holmch11/CVHS_ROV/README.md

# CVHS_ROV
Low Cost 4 Thruster ROV
<<<<<<< Updated upstream
See PDFs or CVHS_ROV_USER_MANUAL for further information
=======
See Pdfs for code map and CVHS_ROV_USER_MANUAL for usage info
>>>>>>> Stashed changes
