holmch11/CVHS_ROV/DXFs/2302-01202-00002.dxf

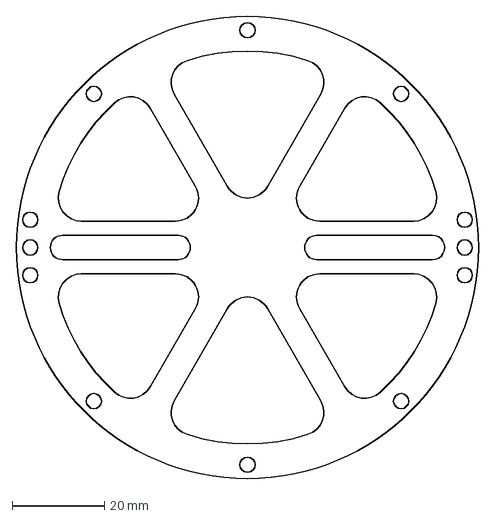
[picture p1: CAD file, 2024-09-09]
DXFs/2302-01202-00002.dxf
100.0 x 100.0 mm
