holmch11/CVHS_ROV/STLs/2302-01200-00009.stl

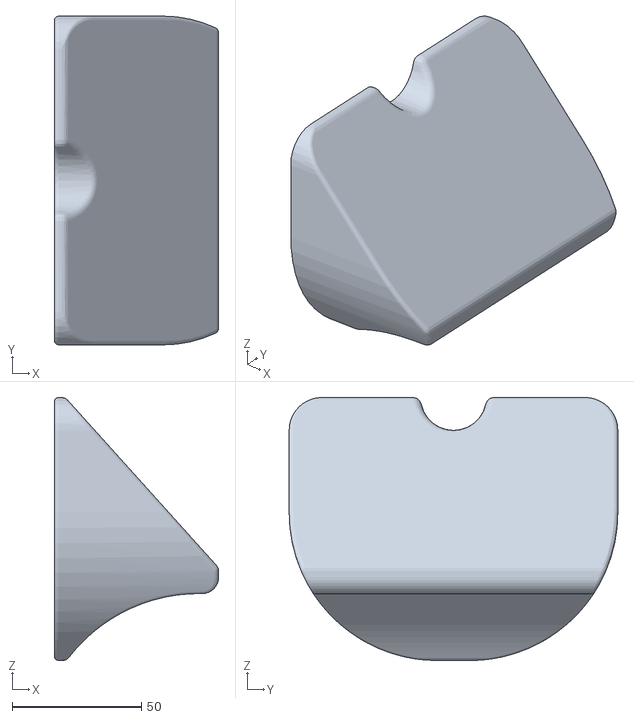
[picture p2: CAD file, 2024-09-09]
STLs/2302-01200-00009.stl
63.5 x 127.0 x 101.6
