holmch11/CVHS_ROV/DXFs/2302-01202-00003.dxf

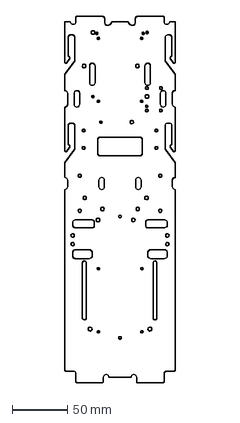
[picture p3: CAD file, 2024-09-09]
DXFs/2302-01202-00003.dxf
100.0 x 331.8 mm
