holmch11/CVHS_ROV/STLs/2302-01200-00003.stl

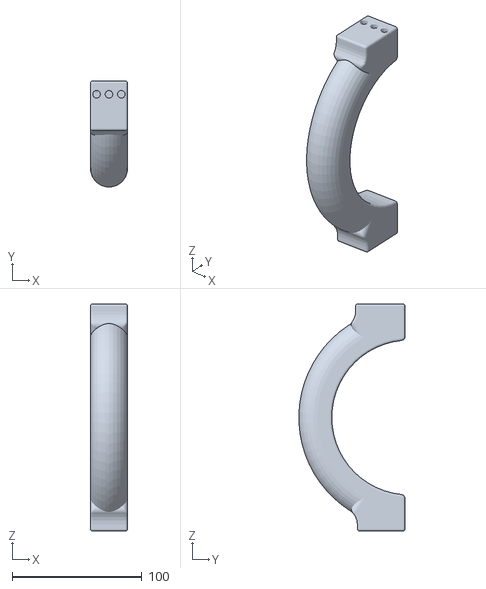
[picture p4: CAD file, 2024-09-09]
STLs/2302-01200-00003.stl
28.6 x 81.7 x 174.6
