holmch11/CVHS_ROV/DXFs/2302-01202-00009.dxf

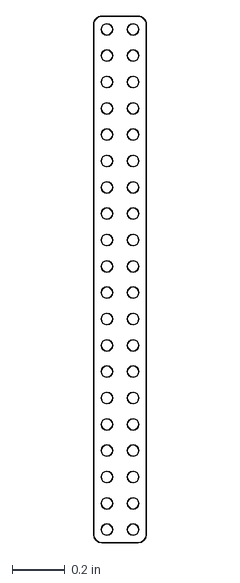
[picture p5: CAD file, 2024-09-09]
DXFs/2302-01202-00009.dxf
0.2 x 2.00 in
