holmch11/CVHS_ROV/STLs/2302-01200-00010.stl

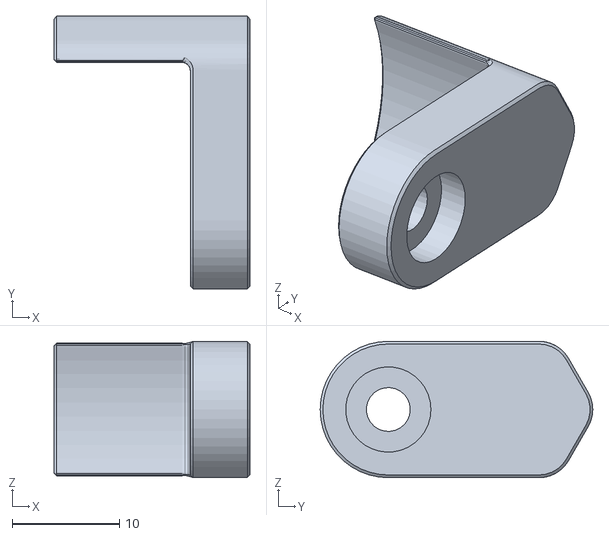
[picture p6: CAD file, 2024-09-09]
STLs/2302-01200-00010.stl
18.3 x 25.4 x 12.7
