holmch11/CVHS_ROV/DXFs/2302-01200-00002.dxf

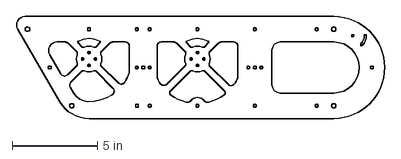
[picture p7: CAD file, 2024-09-09]
DXFs/2302-01200-00002.dxf
21.7 x 6.00 in
