holmch11/CVHS_ROV/STLs/2302-01200-10008.stl

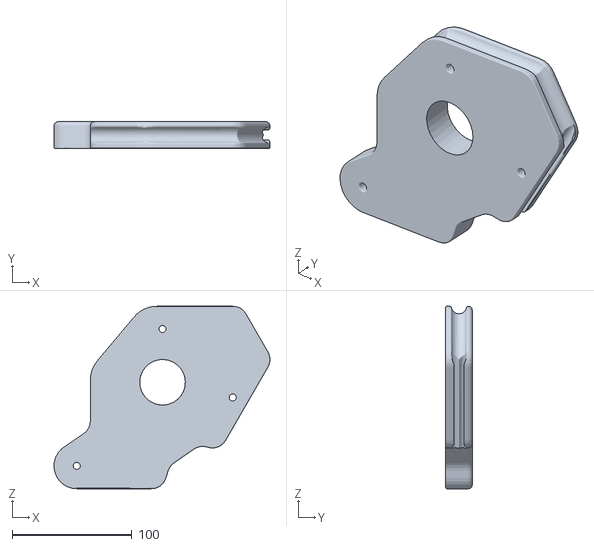
[picture p8: CAD file, 2024-09-09]
STLs/2302-01200-10008.stl
180.4 x 22.2 x 152.4
