holmch11/CVHS_ROV/STLs/2302-01202-00010.stl

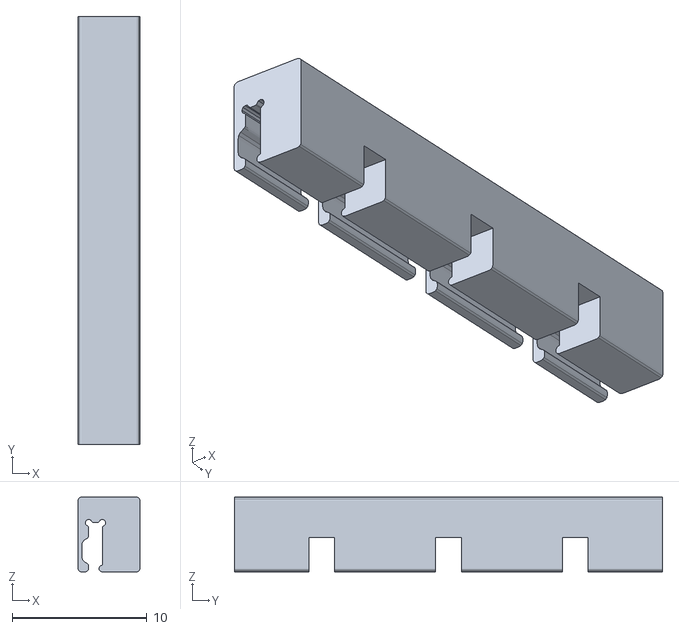
[picture p9: CAD file, 2024-09-09]
STLs/2302-01202-00010.stl
4.60 x 31.8 x 5.56
