holmch11/CVHS_ROV/PDFs/2302-01202_CVHS_ELECTRONICS_BOTTLE_ASSEMBLY_REV-A_2024-09-06.pdf

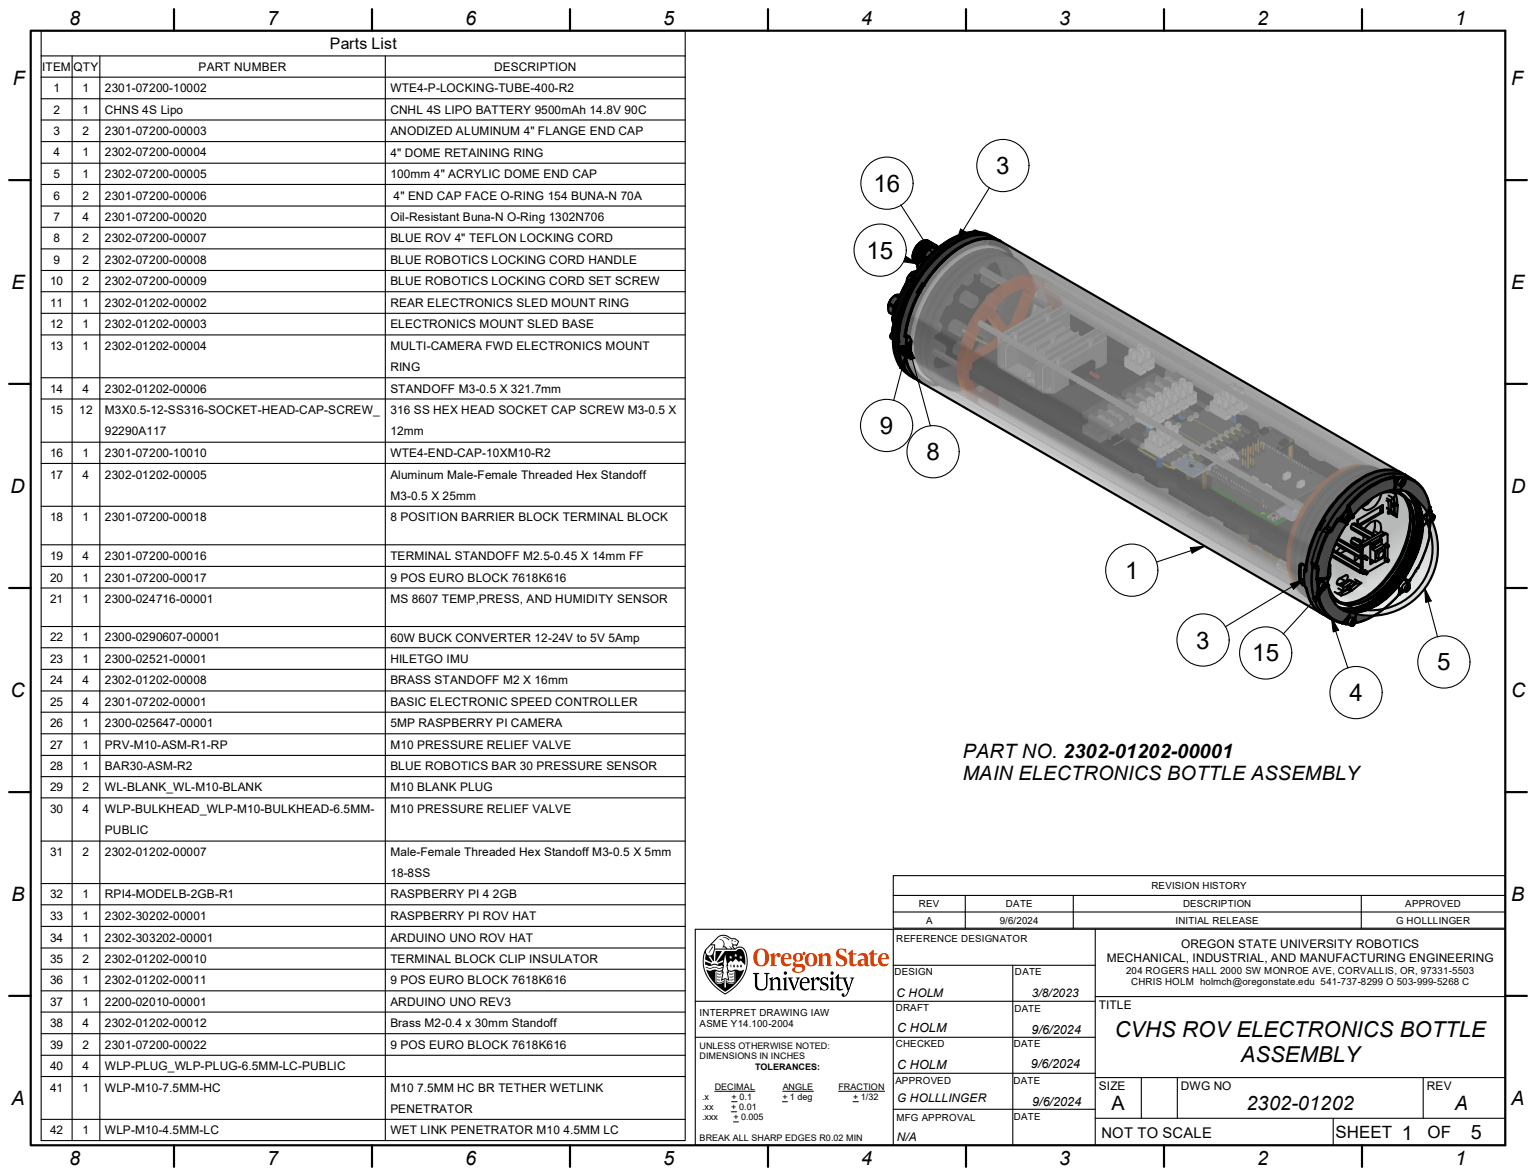
[picture p18: page 1]
Parts List; ARDUINO UNO ROV HAT; TERMINAL BLOCK CLIP INSULATOR; 9 POS EURO BLOCK 7618K616; WLP-M10-4.5MM-LC; WET LINK PENETRATOR M10 4.5MM LC; + 1 deg; .xxx; DWG NO; SHEET 1; MFG APPROVAL; REFERENCE DESIGNATOR; G HOLLLINGER; C HOLM; REVISION HISTORY

ITEM QTY | | PART NUMBER | DESCRIPTION

1 | 1 | 2301-07200-10002 | WTE4-P-LOCKING-TUBE-400-R2

2 | 1 | CHNS 4S Lipo | CNHL 4S LIPO BATTERY 9500mAh 14.8V 90C

3 | 2 | 2301-07200-00003 | ANODIZED ALUMINUM 4" FLANGE END CAP

4 | 1 | 2302-07200-00004 | 4" DOME RETAINING RING

5 | 1 | 2302-07200-00005 | 100mm 4" ACRYLIC DOME END CAP

6 | 2 | 2301-07200-00006 | 4" END CAP FACE O-RING 154 BUNA-N 70A

7 | 4 | 2301-07200-00020 | Oil-Resistant Buna-N O-Ring 1302N706

8 | 2 | 2302-07200-00007 | BLUE ROV 4" TEFLON LOCKING CORD

9 | 2 | 2302-07200-00008 | BLUE ROBOTICS LOCKING CORD HANDLE

10 | 2 | 2302-07200-00009 | BLUE ROBOTICS LOCKING CORD SET SCREW

11 | 1 | 2302-01202-00002 | REAR ELECTRONICS SLED MOUNT RING

12 | 1 | 2302-01202-00003 | ELECTRONICS MOUNT SLED BASE

13 | 1 | 2302-01202-00004 | MULTI-CAMERA FWD ELECTRONICS MOUNT RING

14 | 4 | 2302-01202-00006 | STANDOFF M3-0.5 X 321.7mm

15 | 12 | M3X0.5-12-SS316-SOCKET-HEAD-CAP-SCREW_ 92290A117 | 316 SS HEX HEAD SOCKET CAP SCREW M3-0.5 X 12mm

16 | 1 | 2301-07200-10010 | WTE4-END-CAP-10XM10-R2

17 | 4 | 2302-01202-00005 | Aluminum Male-Female Threaded Hex Standoff M3-0.5 X 25mm

18 | 1 | 2301-07200-00018 | 8 POSITION BARRIER BLOCK TERMINAL BLOCK

19 | 4 | 2301-07200-00016 | TERMINAL STANDOFF M2.5-0.45 X 14mm FF

20 | 1 | 2301-07200-00017 | 9 POS EURO BLOCK 7618K616

21 | 1 | 2300-024716-00001 | MS 8607 TEMP,PRESS, AND HUMIDITY SENSOR

22 | 1 | 2300-0290607-00001 | 60W BUCK CONVERTER 12-24V to 5V 5Amp

23 | 1 | 2300-02521-00001 | HILETGO IMU

24 | 4 | 2302-01202-00008 | BRASS STANDOFF M2 X 16mm

25 | 4 | 2301-07202-00001 | BASIC ELECTRONIC SPEED CONTROLLER

26 | 1 | 2300-025647-00001 | 5MP RASPBERRY PI CAMERA

27 | 1 | PRV-M10-ASM-R1-RP | M10 PRESSURE RELIEF VALVE

PART NO. 2302-01202-00001
MAIN ELECTRONICS BOTTLE ASSEMBLY

28 | 1 | BAR30-ASM-R2 | BLUE ROBOTICS BAR 30 PRESSURE SENSOR

29 | 2 | WL-BLANK_WL-M10-BLANK | M10 BLANK PLUG

30 | 4 | WLP-BULKHEAD_WLP-M10-BULKHEAD-6.5MM-PUBLIC | M10 PRESSURE RELIEF VALVE

31 | 2 | 2302-01202-00007 | Male-Female Threaded Hex Standoff M3-0.5 X 5mm 18-8SS

32 | 1 | RPI4-MODELB-2GB-R1 | RASPBERRY PI 4 2GB

33 | 1 | 2302-30202-00001 | RASPBERRY PI ROV HAT

REV | DATE | DESCRIPTION | APPROVED
A | 9/6/2024 | INITIAL RELEASE | G HOLLLINGER

OREGON STATE UNIVERSITY ROBOTICS

MECHANICAL, INDUSTRIAL, AND MANUFACTURING ENGINEERING
204 ROGERS HALL 2000 SW MONROE AVE, CORVALLIS, OR, 97331-5503
CHRIS HOLM holmch@oregonstate.edu 541-737-8299 O 503-999-5268 C

37 | 1 | 2200-02010-00001 | ARDUINO UNO REV3

INTERPRET DRAWING IAW ASME Y14.100-2004 | DRAFT C HOLM | DATE 9/6/2024

TITLE
CVHS ROV ELECTRONICS BOTTLE

38 | 4 | 2302-01202-00012 | Brass M2-0.4 x 30mm Standoff

UNLESS OTHERWISE NOTED:
DIMENSIONS IN INCHES

M10 7.5MM HC BR TETHER WETLINK

BREAK ALL SHARP EDGES R0.02 MIN

NOT TO SCALE

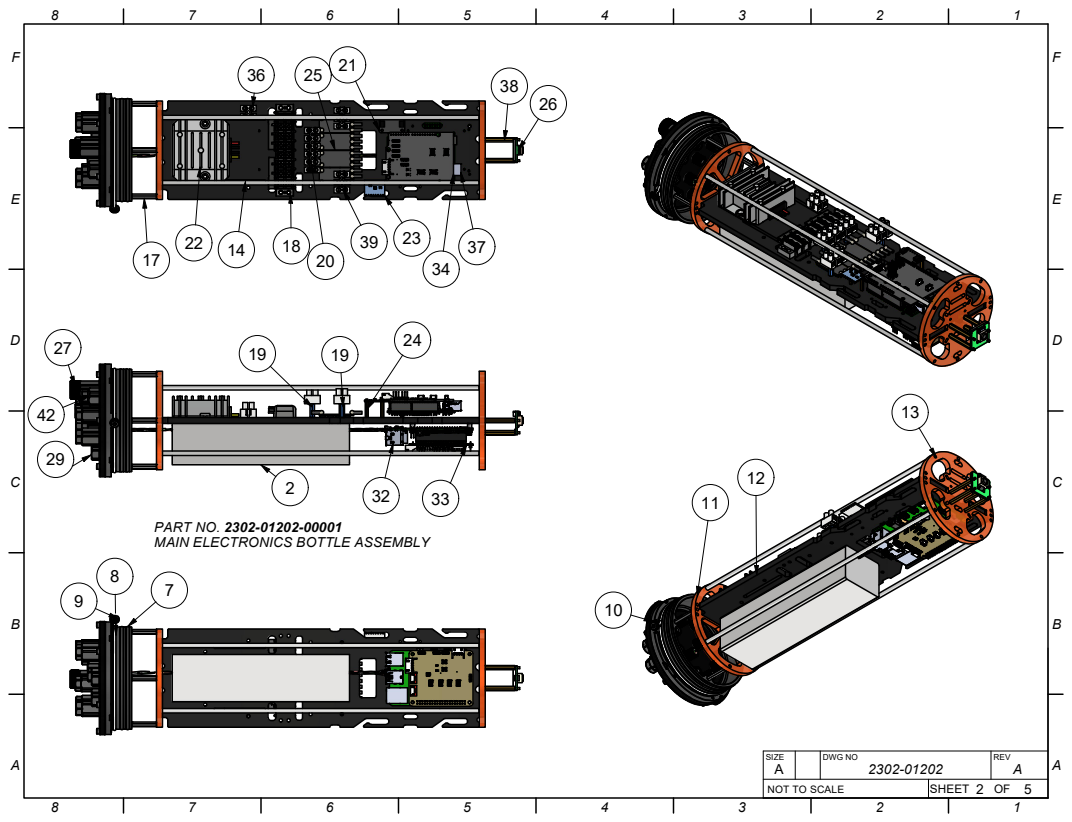
[picture p19: page 2]
SIZE; DWG NO; REV; NOT TO SCALE; SHEET

PART NO. 2302-01202-00001
MAIN ELECTRONICS BOTTLE ASSEMBLY

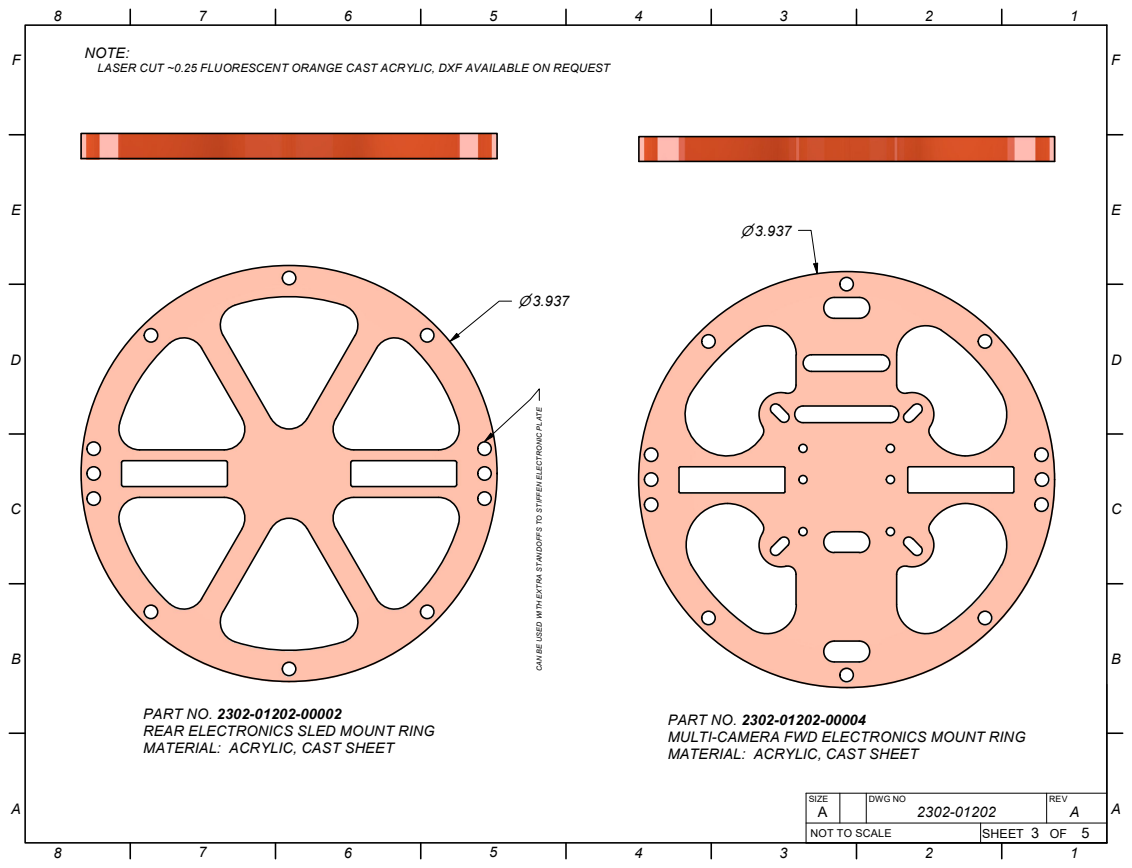
[picture p20: page 3]
SIZE; DWG NO; REV

NOTE:
LASER CUT ~0.25 FLUORESCENT ORANGE CAST ACRYLIC, DXF AVAILABLE ON REQUEST

CAN BE USED WITH EXTRA STANDOFFS TO STIFFEN ELECTRONIC PLATE

PART NO. 2302-01202-00002
REAR ELECTRONICS SLED MOUNT RING
MATERIAL: ACRYLIC, CAST SHEET

PART NO. 2302-01202-00004
MULTI-CAMERA FWD ELECTRONICS MOUNT RING

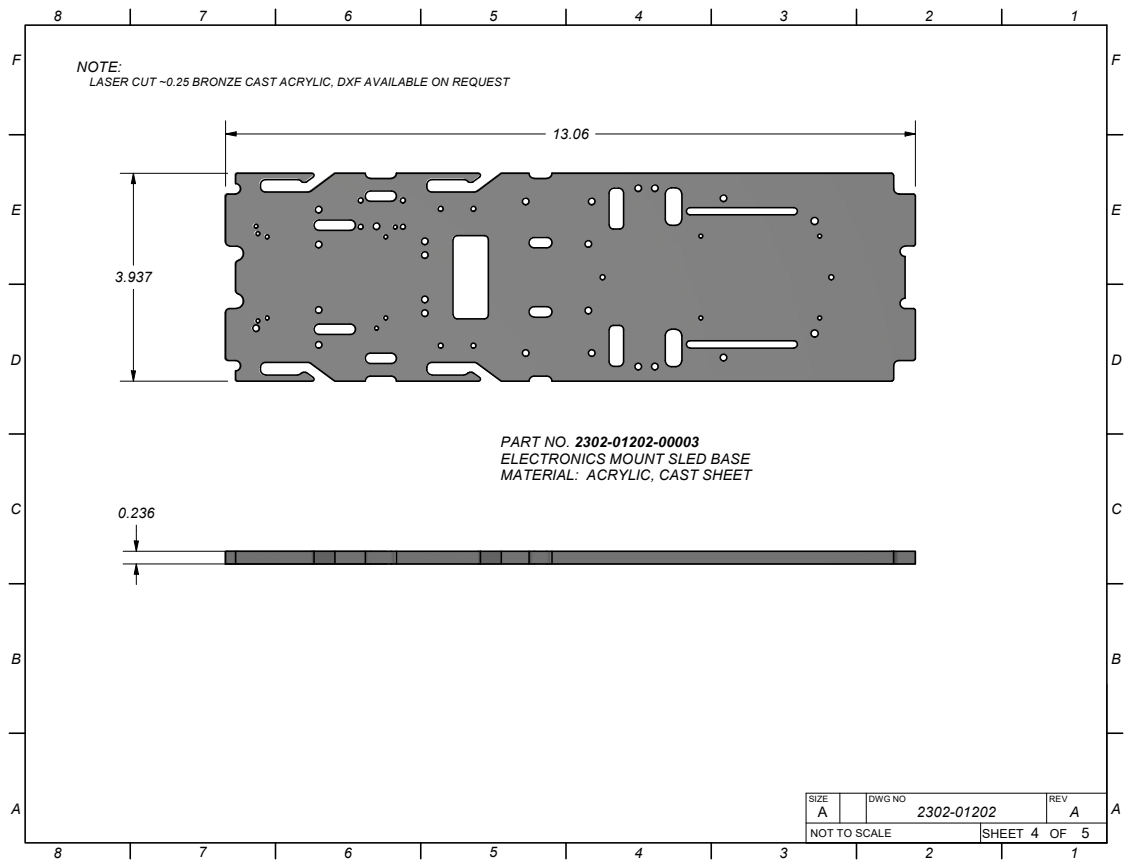
[picture p21: page 4]
SIZE; DWG NO; REV

NOTE:
LASER CUT ~0.25 BRONZE CAST ACRYLIC, DXF AVAILABLE ON REQUEST

PART NO. 2302-01202-00003
ELECTRONICS MOUNT SLED BASE
MATERIAL: ACRYLIC, CAST SHEET

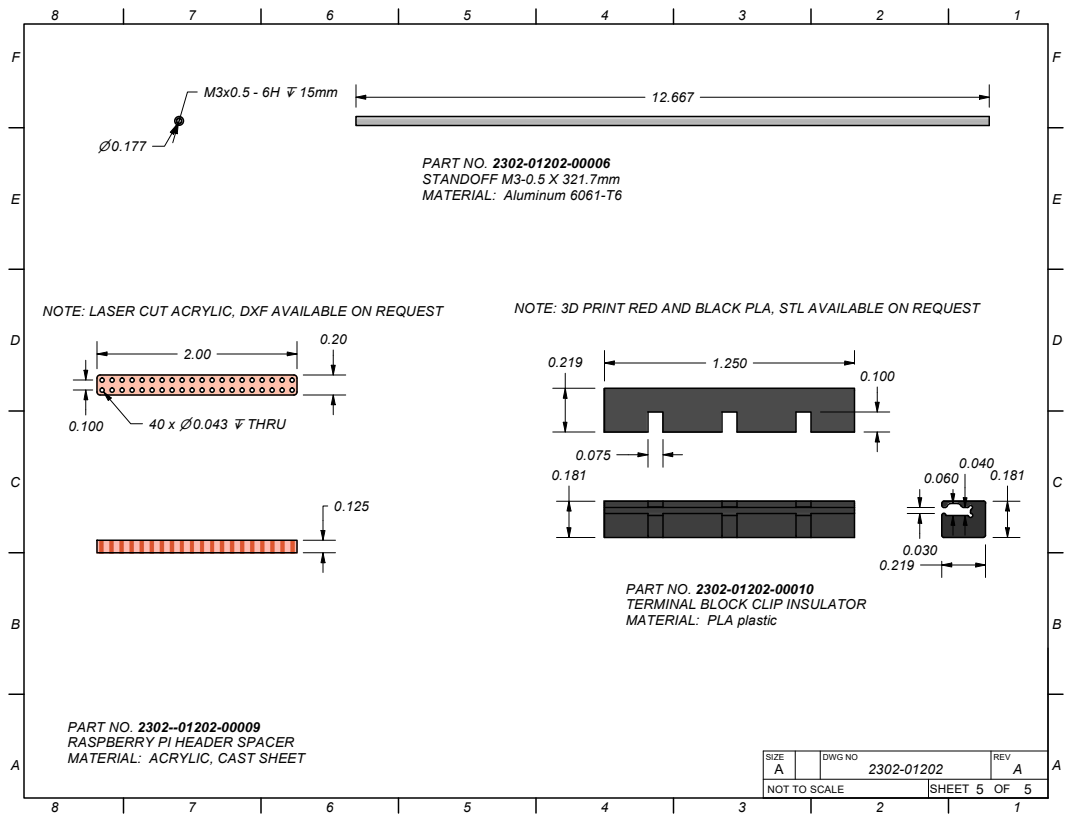
[picture p22: page 5]
PART NO. 2302-01202-00006 STANDOFF M3-0.5 X 321.7mm MATERIAL: Aluminum 6061-T6; SIZE; DWG NO; REV; 40 x ⌀ 0.043 ↧ THRU; NOTE: LASER CUT ACRYLIC, DXF AVAILABLE ON REQUEST; NOTE: 3D PRINT RED AND BLACK PLA, STL AVAILABLE ON REQUEST

PART NO. 2302-01202-00010
TERMINAL BLOCK CLIP INSULATOR
MATERIAL: PLA plastic

PART NO. 2302--01202-00009
RASPBERRY PI HEADER SPACER
MATERIAL: ACRYLIC, CAST SHEET
