holmch11/CVHS_ROV/PDFs/2302-01200_CVHS_4_THRUSTER_ROV_ASSEMBLY_REV-A_2024-09-06.pdf

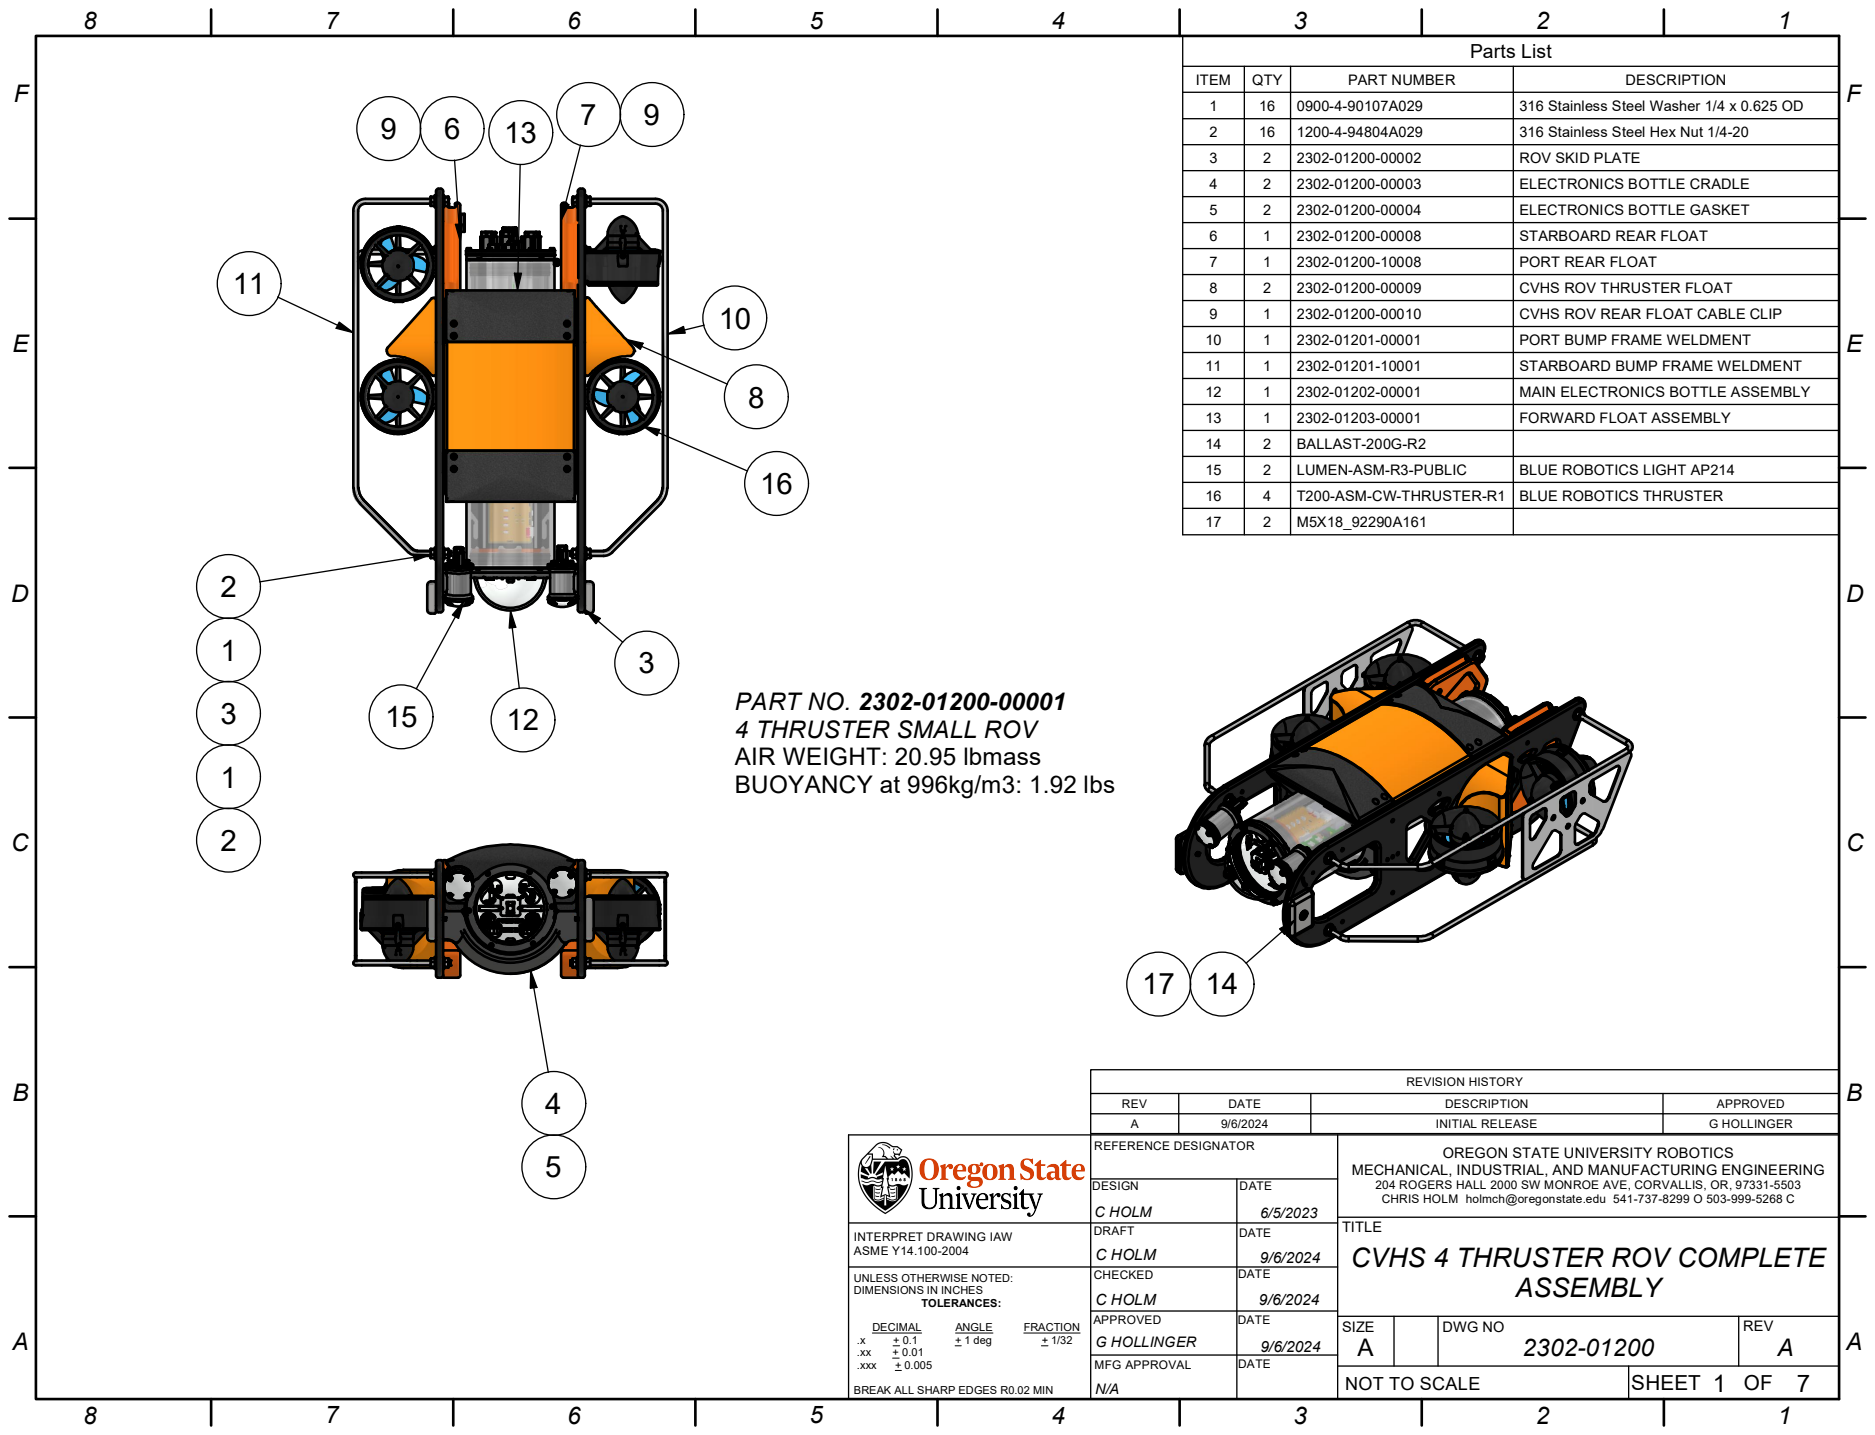
[picture p23: page 1]
Parts List; ITEM; QTY; PART NUMBER; DESCRIPTION; 316 Stainless Steel Washer 1/4 x 0.625 OD; 316 Stainless Steel Hex Nut 1/4-20; ROV SKID PLATE; ELECTRONICS BOTTLE CRADLE; ELECTRONICS BOTTLE GASKET; STARBOARD REAR FLOAT; PORT REAR FLOAT; CVHS ROV THRUSTER FLOAT; CVHS ROV REAR FLOAT CABLE CLIP; PORT BUMP FRAME WELDMENT; STARBOARD BUMP FRAME WELDMENT; MAIN ELECTRONICS BOTTLE ASSEMBLY; FORWARD FLOAT ASSEMBLY; LUMEN-ASM-R3-PUBLIC; BLUE ROBOTICS LIGHT AP214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

PART NO. 2302-01200-00001
4 THRUSTER SMALL ROV
AIR WEIGHT: 20.95 lbmass
BUOYANCY at 996kg/m3: 1.92 lbs

OREGON STATE UNIVERSITY ROBOTICS

MECHANICAL, INDUSTRIAL, AND MANUFACTURING ENGINEERING
204 ROGERS HALL 2000 SW MONROE AVE, CORVALLIS, OR, 97331-5503
CHRIS HOLM holmch@oregonstate.edu 541-737-8299 O 503-999-5268 C

TITLE
CVHS 4 THRUSTER ROV COMPLETE

INTERPRET DRAWING IAW
ASME Y14.100-2004

UNLESS OTHERWISE NOTED:
DIMENSIONS IN INCHES

BREAK ALL SHARP EDGES R0.02 MIN

NOT TO SCALE

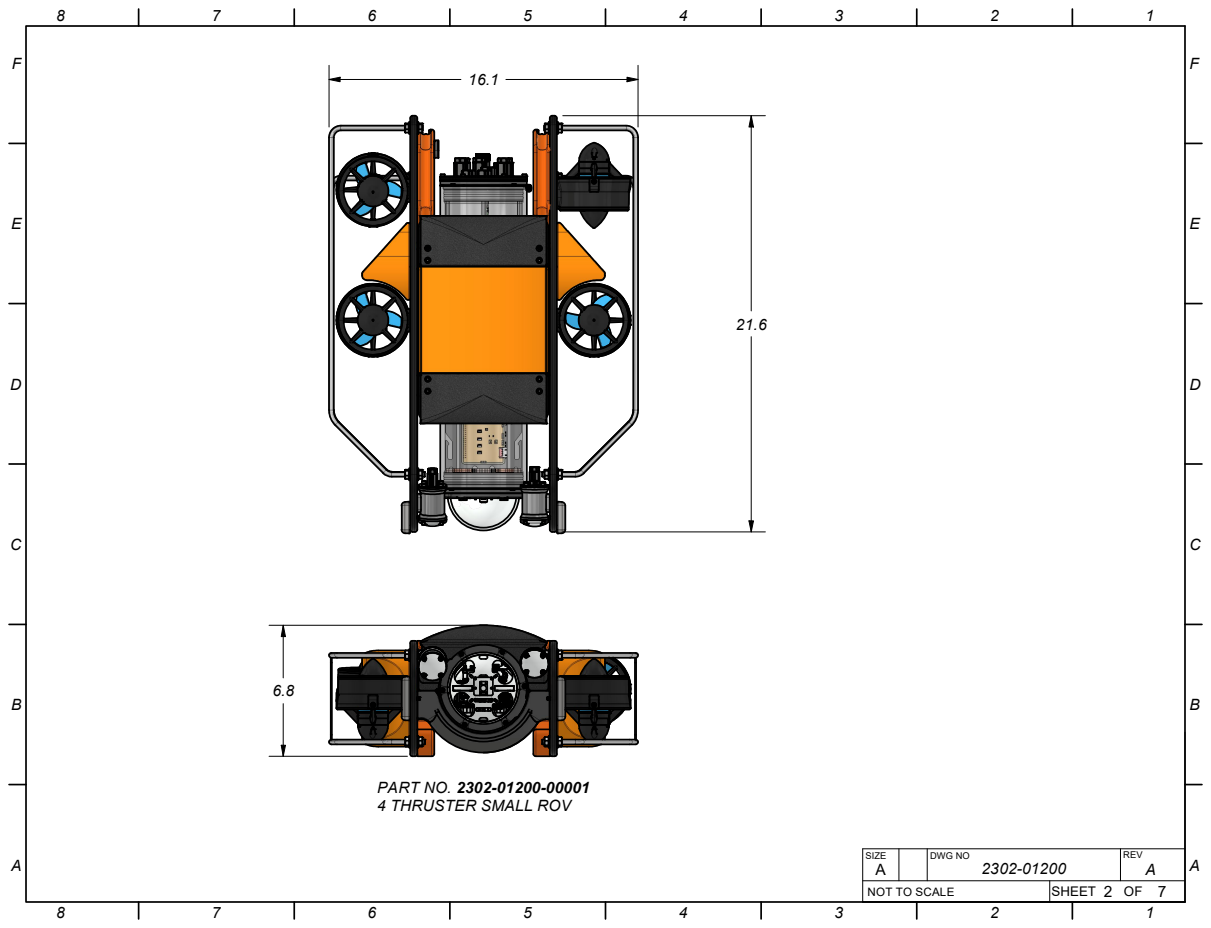
[picture p24: page 2]

PART NO. 2302-01200-00001
4 THRUSTER SMALL ROV

SIZE | | DWG NO | REV

NOT TO SCALE | SHEET OF

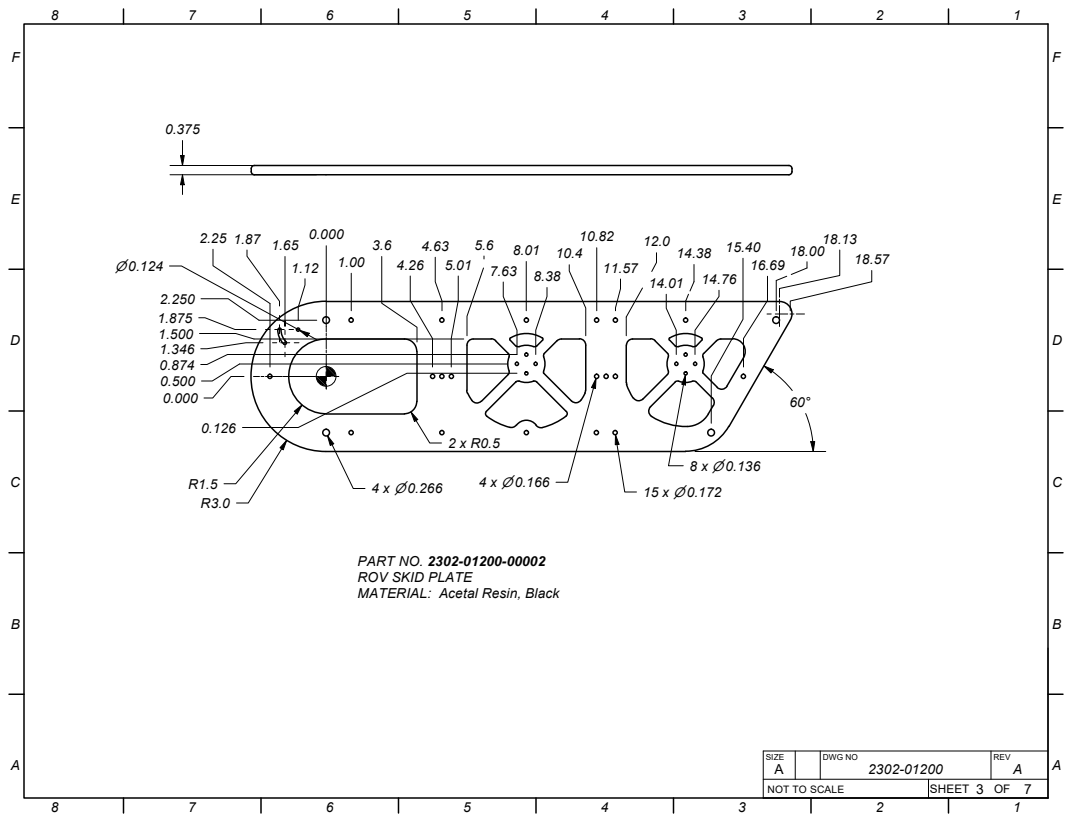
[picture p25: page 3]
SIZE; DWG NO; REV

PART NO. 2302-01200-00002
ROV SKID PLATE
MATERIAL: Acetal Resin, Black

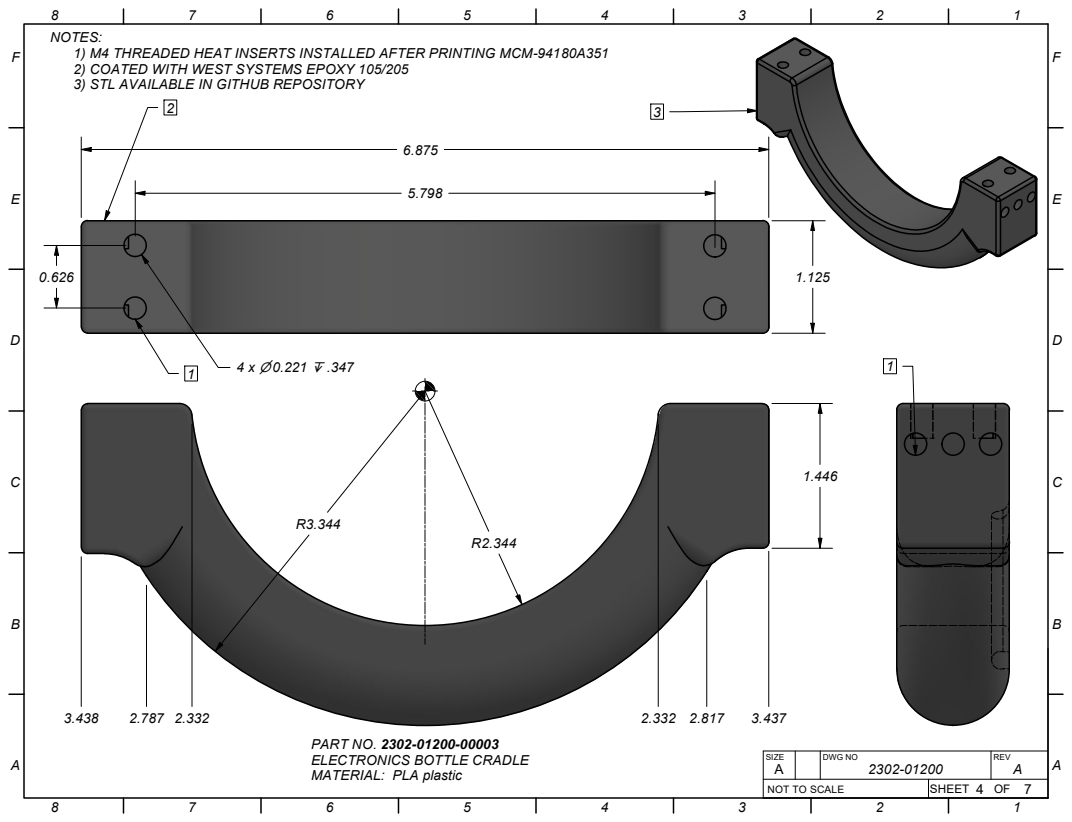
[picture p26: page 4]
SIZE; DWG NO; REV

NOTES:
1) M4 THREADED HEAT INSERTS INSTALLED AFTER PRINTING MCM-94180A351
2) COATED WITH WEST SYSTEMS EPOXY 105/205
3) STL AVAILABLE IN GITHUB REPOSITORY

PART NO. 2302-01200-00003
ELECTRONICS BOTTLE CRADLE
MATERIAL: PLA plastic

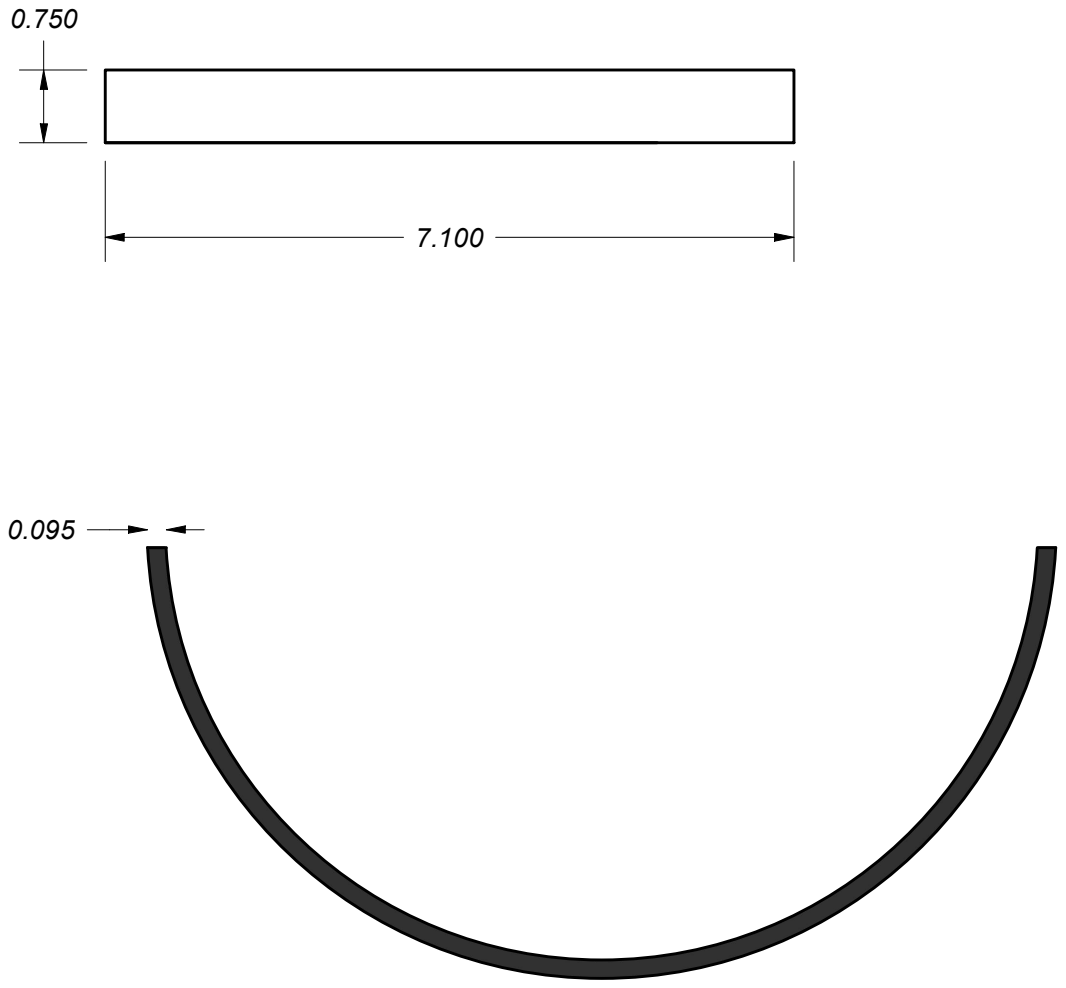
[picture p27: page 5]
SIZE; DWG NO; REV

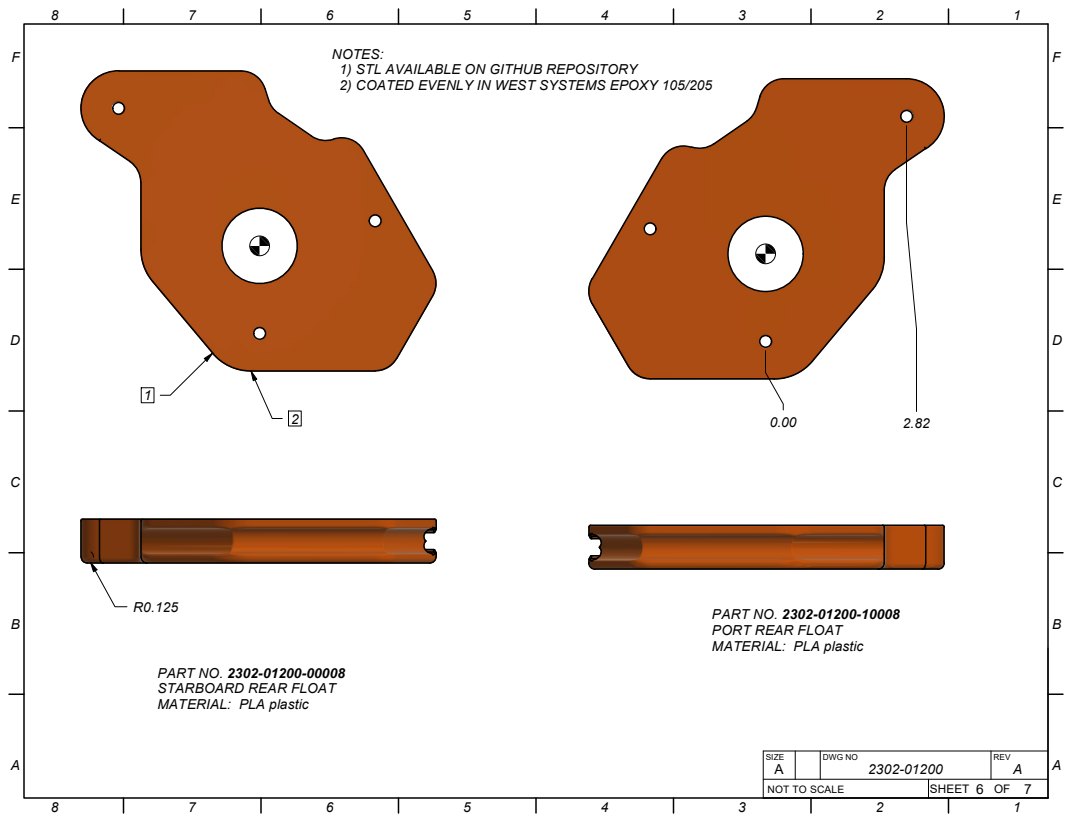
[picture p28: page 6]
SIZE; DWG NO; REV

NOTES:
1) STL AVAILABLE ON GITHUB REPOSITORY
2) COATED EVENLY IN WEST SYSTEMS EPOXY 105/205

PART NO. 2302-01200-10008
PORT REAR FLOAT
MATERIAL: PLA plastic

PART NO. 2302-01200-00008
STARBOARD REAR FLOAT

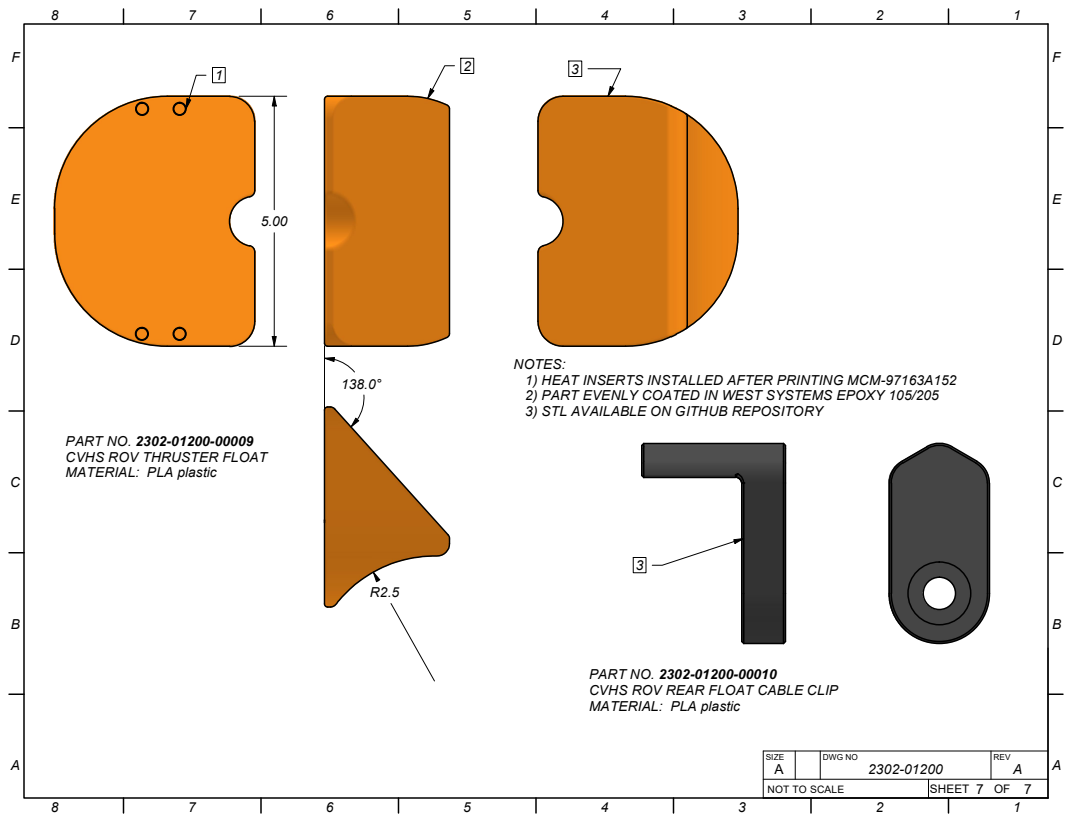
[picture p29: page 7]
SIZE; DWG NO; REV

NOTES:
1) HEAT INSERTS INSTALLED AFTER PRINTING MCM-97163A152
2) PART EVENLY COATED IN WEST SYSTEMS EPOXY 105/205
3) STL AVAILABLE ON GITHUB REPOSITORY

PART NO. 2302-01200-00009
CVHS ROV THRUSTER FLOAT
MATERIAL: PLA plastic

PART NO. 2302-01200-00010
CVHS ROV REAR FLOAT CABLE CLIP
