holmch11/CVHS_ROV/PDFs/2302-01203_CVHS_ROV_FOAM_CLAMP_ASSEMBLY_REV-A_2024-09-06.pdf

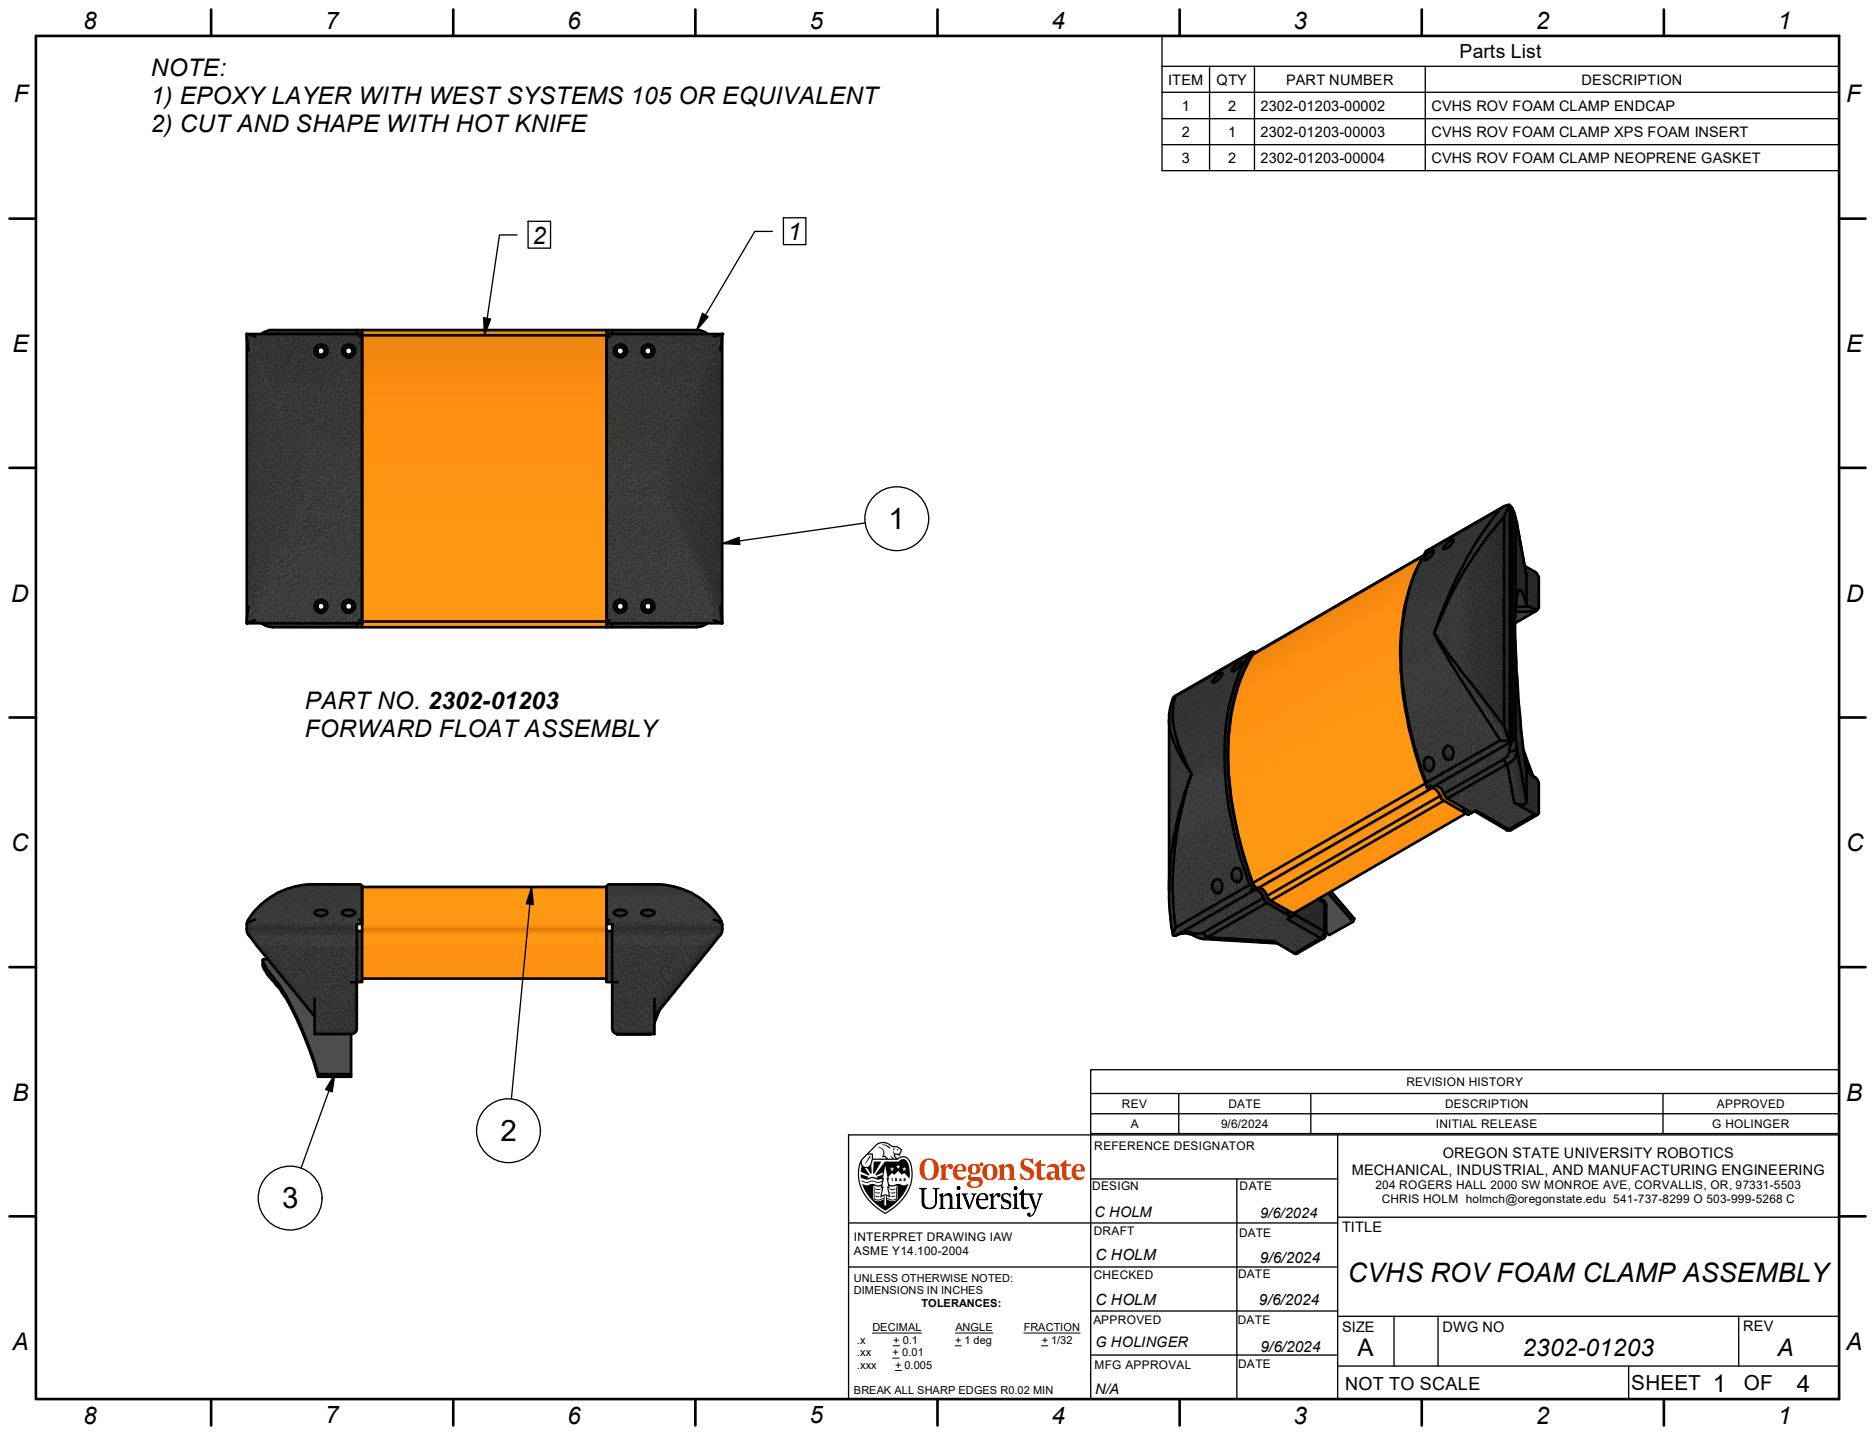
[picture p30: page 1]
Parts List; REVISION HISTORY

NOTE:
1) EPOXY LAYER WITH WEST SYSTEMS 105 OR EQUIVALENT
2) CUT AND SHAPE WITH HOT KNIFE

ITEM | QTY | PART NUMBER | DESCRIPTION

1 | 2 | 2302-01203-00002 | CVHS ROV FOAM CLAMP ENDCAP

2 | 1 | 2302-01203-00003 | CVHS ROV FOAM CLAMP XPS FOAM INSERT

3 | 2 | 2302-01203-00004 | CVHS ROV FOAM CLAMP NEOPRENE GASKET

PART NO. 2302-01203
FORWARD FLOAT ASSEMBLY

REV | DATE | DESCRIPTION | APPROVED
A | 9/6/2024 | INITIAL RELEASE | G HOLINGER
REFERENCE DESIGNATOR | OREGON STATE UNIVERSITY ROBOTICS MECHANICAL, INDUSTRIAL, AND MANUFACTURING ENGINEERING 204 ROGERS HALL 2000 SW MONROE AVE, CORVALLIS, OR, 97331-5503 CHRIS HOLM holmch@oregonstate.edu 541-737-8299 O 503-999-5268 C TITLE

DESIGN C HOLM | DATE 9/6/2024

INTERPRET DRAWING IAW ASME Y14.100-2004 | DRAFT C HOLM | DATE 9/6/2024

UNLESS OTHERWISE NOTED: TOLERANCES: DECIMAL ANGLE FRACTION .x + 0.1 + 1 deg + 1/32 .xx + 0.01 .xxx + 0.005 BREAK ALL SHARP EDGES R0.02 MIN | CHECKED C HOLM | DATE 9/6/2024 | CVHS ROV FOAM CLAMP ASSEMBLY DIMENSIONS IN INCHES

APPROVED G HOLINGER | DATE 9/6/2024 | SIZE A | | DWG NO | REV A

MFG APPROVAL N/A | DATE

NOT TO SCALE | SHEET 1 4 OF

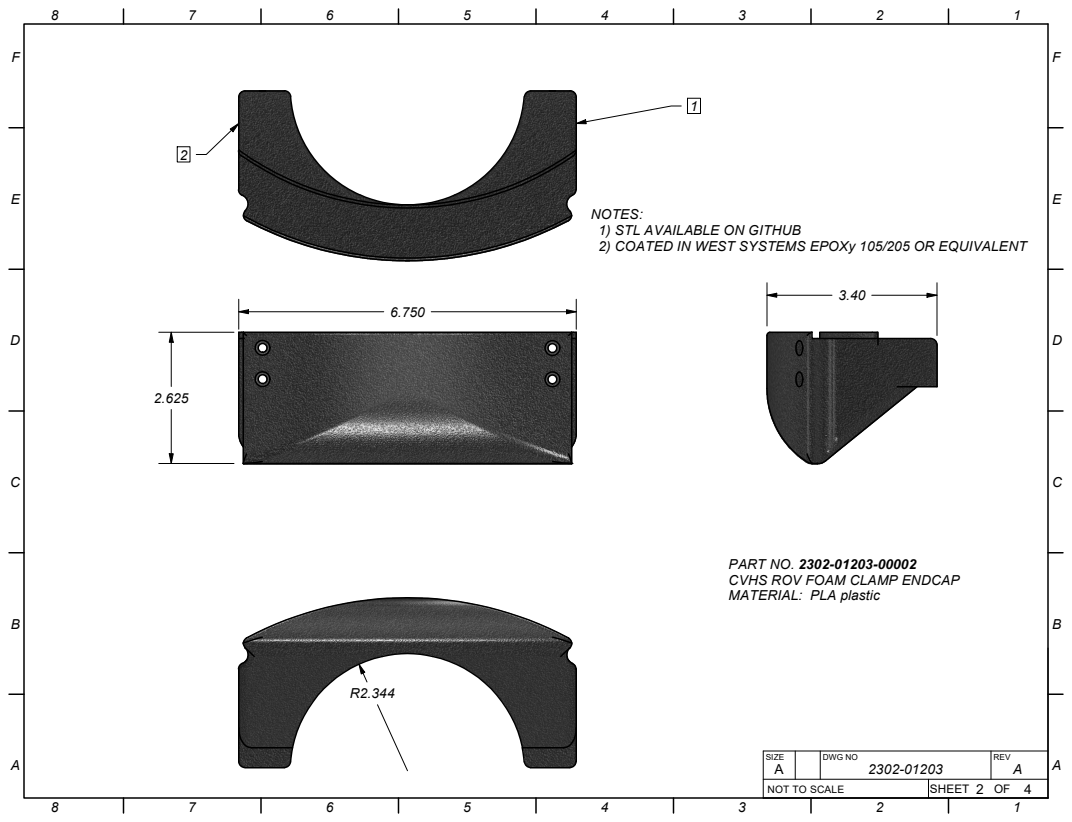
[picture p31: page 2]

NOTES:
1) STL AVAILABLE ON GITHUB
2) COATED IN WEST SYSTEMS EPOXy 105/205 OR EQUIVALENT

PART NO. 2302-01203-00002
CVHS ROV FOAM CLAMP ENDCAP
MATERIAL: PLA plastic

SIZE | | DWG NO | REV

NOT TO SCALE | SHEET OF

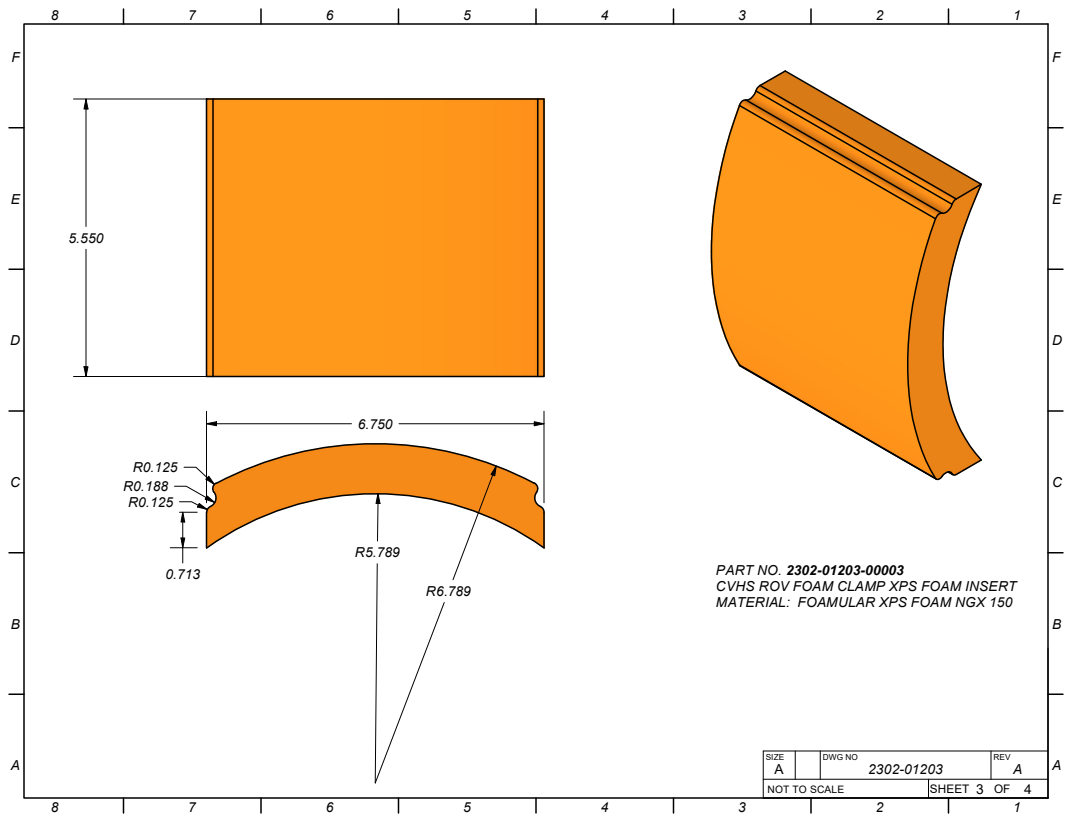
[picture p32: page 3]
SIZE; DWG NO; REV

PART NO. 2302-01203-00003
CVHS ROV FOAM CLAMP XPS FOAM INSERT
MATERIAL: FOAMULAR XPS FOAM NGX 150

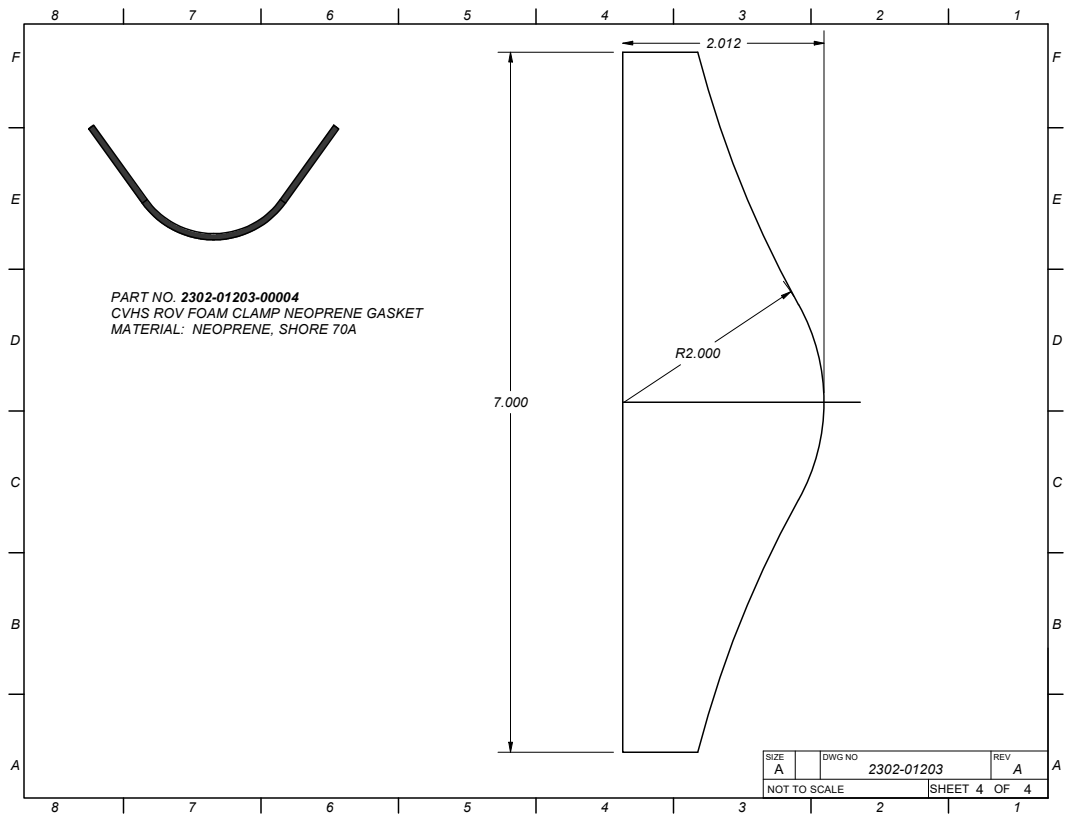
[picture p33: page 4]
SIZE; DWG NO; REV

PART NO. 2302-01203-00004
CVHS ROV FOAM CLAMP NEOPRENE GASKET
MATERIAL: NEOPRENE, SHORE 70A
