holmch11/CVHS_ROV/PDFs/2302-21202_CVHS_ELECTRONICS_BOTTLE_WIRING_REV-A_2024-08-16.pdf

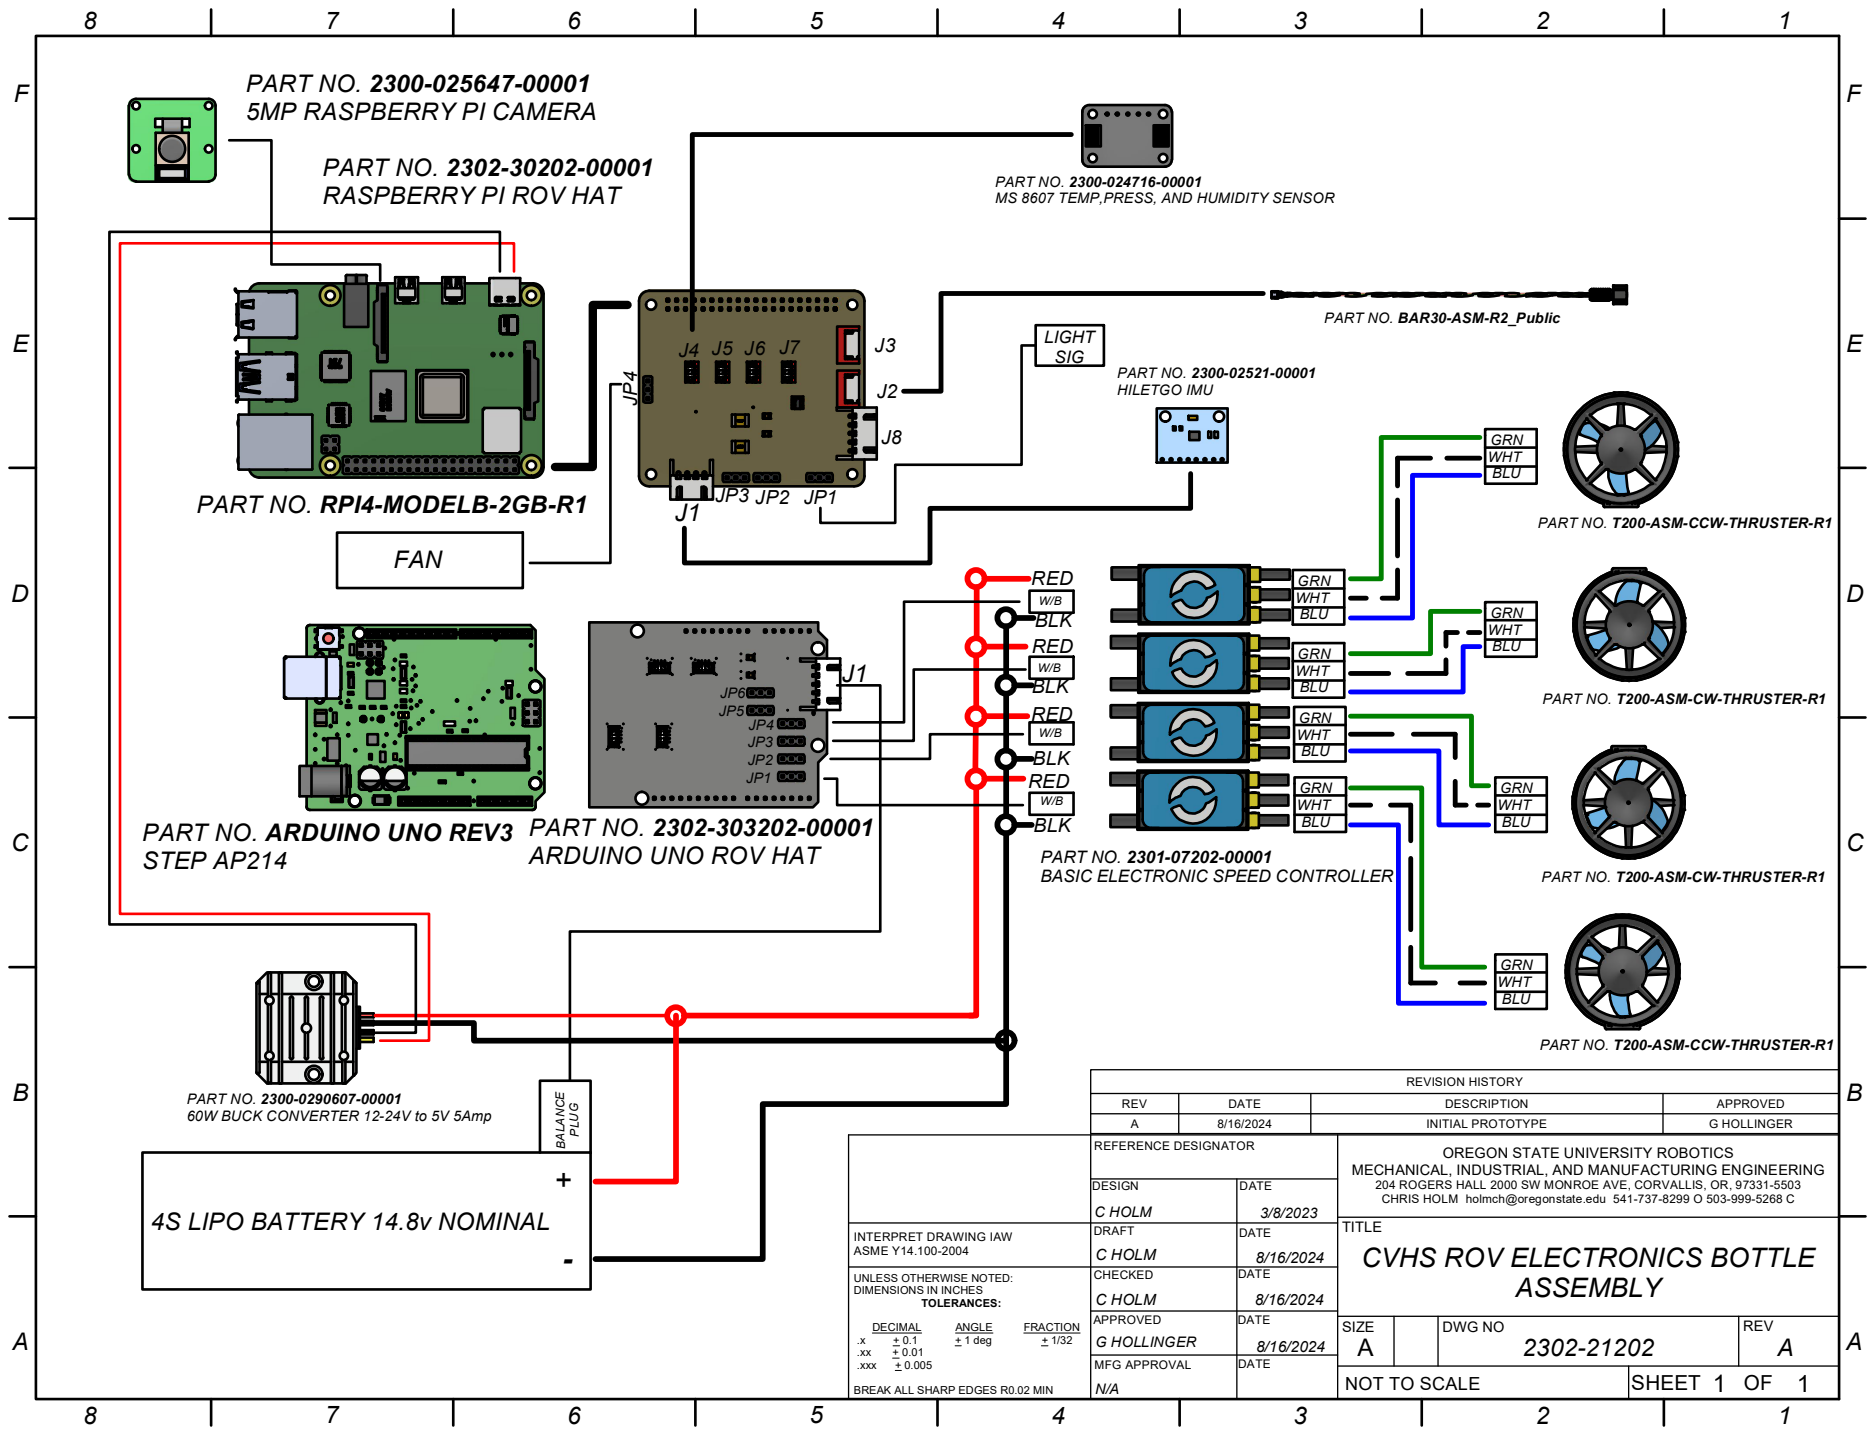
[picture p34: page 1]

PART NO. 2302-30202-00001
RASPBERRY PI ROV HAT

PART NO. 2300-024716-00001
MS 8607 TEMP,PRESS, AND HUMIDITY SENSOR

PART NO. T200-ASM-CCW-THRUSTER-R1

PART NO. T200-ASM-CW-THRUSTER-R1

PART NO. 2302-303202-00001
ARDUINO UNO ROV HAT

PART NO. ARDUINO UNO REV3
STEP AP214

OREGON STATE UNIVERSITY ROBOTICS

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

TITLE
CVHS ROV ELECTRONICS BOTTLE

BREAK ALL SHARP EDGES R0.02 MIN
