holmch11/CVHS_ROV/PDFs/2302-51200_CVHS_4_THRUSTER_ROV_SOFTWARE_MAP_REV-A_2024-09-09.pdf

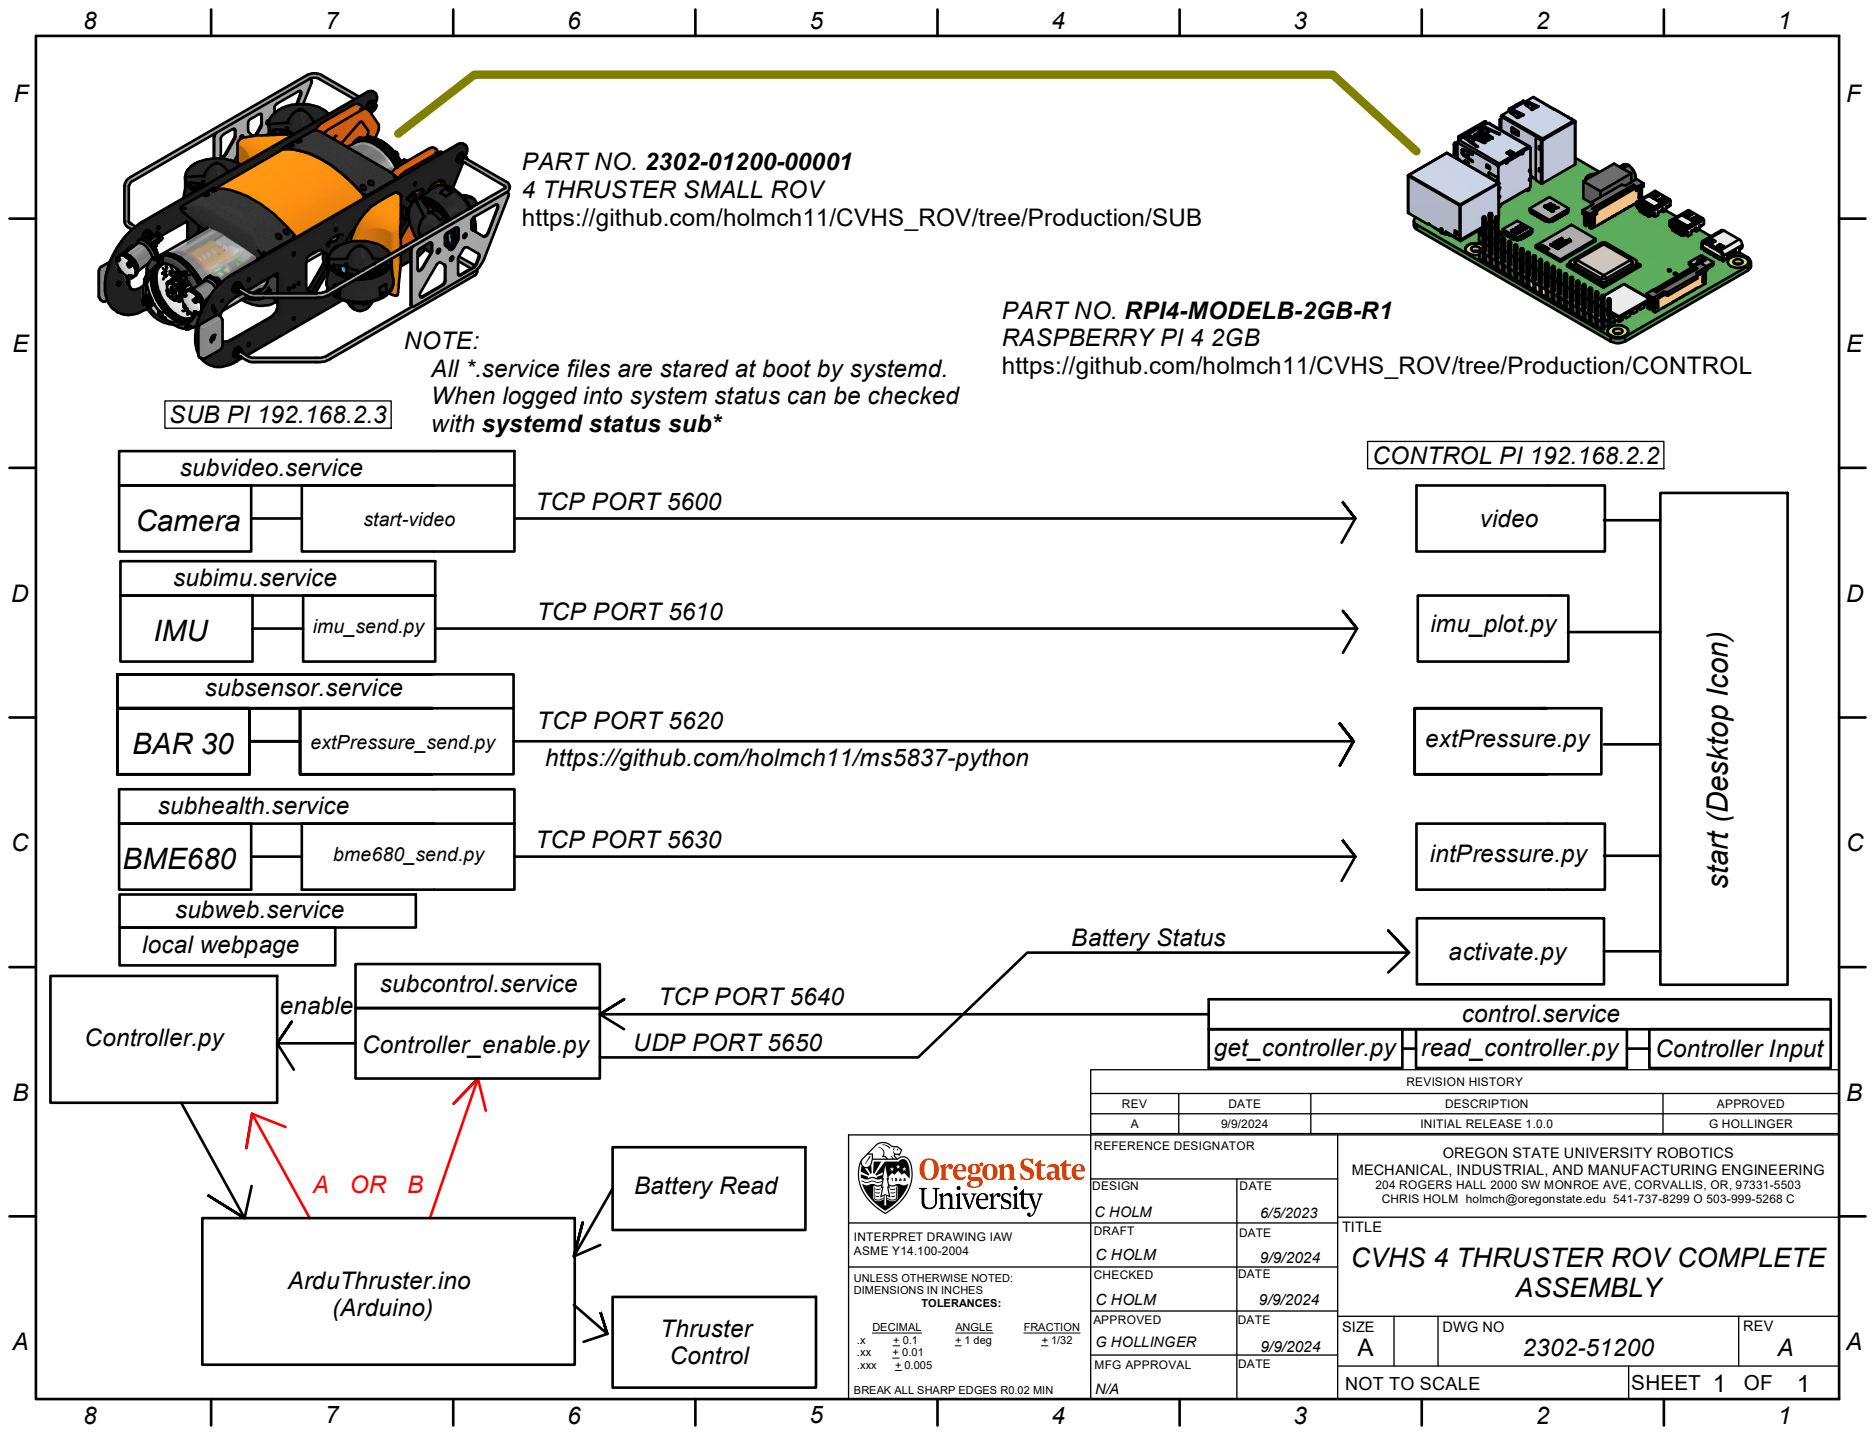
[picture p35: page 1]
C HOLM; TCP PORT 5630; TCP PORT 5610; BAR 30; TCP PORT 5600; TCP PORT 5640; UDP PORT 5650; Battery Status; local webpage; Battery Read; REVISION HISTORY; SUB PI 192.168.2.3; CONTROL PI 192.168.2.2

PART NO. 2302-01200-00001
4 THRUSTER SMALL ROV
https://github.com/holmch11/CVHS_ROV/tree/Production/SUB

PART NO. RPI4-MODELB-2GB-R1
RASPBERRY PI 4 2GB
https://github.com/holmch11/CVHS_ROV/tree/Production/CONTROL

NOTE:
All *.service files are stared at boot by systemd.
When logged into system status can be checked
with systemd status sub*

TCP PORT 5620
https://github.com/holmch11/ms5837-python

control.service

get_controller.py | read_controller.py | Controller Input

REV | DATE | DESCRIPTION | APPROVED
A | 9/9/2024 | INITIAL RELEASE 1.0.0 | G HOLLINGER
REFERENCE DESIGNATOR | OREGON STATE UNIVERSITY ROBOTICS MECHANICAL, INDUSTRIAL, AND MANUFACTURING ENGINEERING 204 ROGERS HALL 2000 SW MONROE AVE, CORVALLIS, OR, 97331-5503 CHRIS HOLM holmch@oregonstate.edu 541-737-8299 O 503-999-5268 C TITLE CVHS 4 THRUSTER ROV COMPLETE ASSEMBLY

DESIGN C HOLM | DATE 6/5/2023

INTERPRET DRAWING IAW
ASME Y14.100-2004

UNLESS OTHERWISE NOTED: DIMENSIONS IN INCHES TOLERANCES: DECIMAL ANGLE FRACTION .x + 0.1 + 1 deg + 1/32 .xx + 0.01 .xxx + 0.005 BREAK ALL SHARP EDGES R0.02 MIN | CHECKED C HOLM | DATE 9/9/2024

APPROVED G HOLLINGER | DATE 9/9/2024 | SIZE A | DWG NO 2302-51200 | REV A

MFG APPROVAL N/A | DATE

NOT TO SCALE | SHEET 1 1 OF
