holmch11/CVHS_ROV/PDFs/2302-01201_CVHS_ROV_BUMP_FRAME_WELMENT_REV-A_2024-09-06.pdf

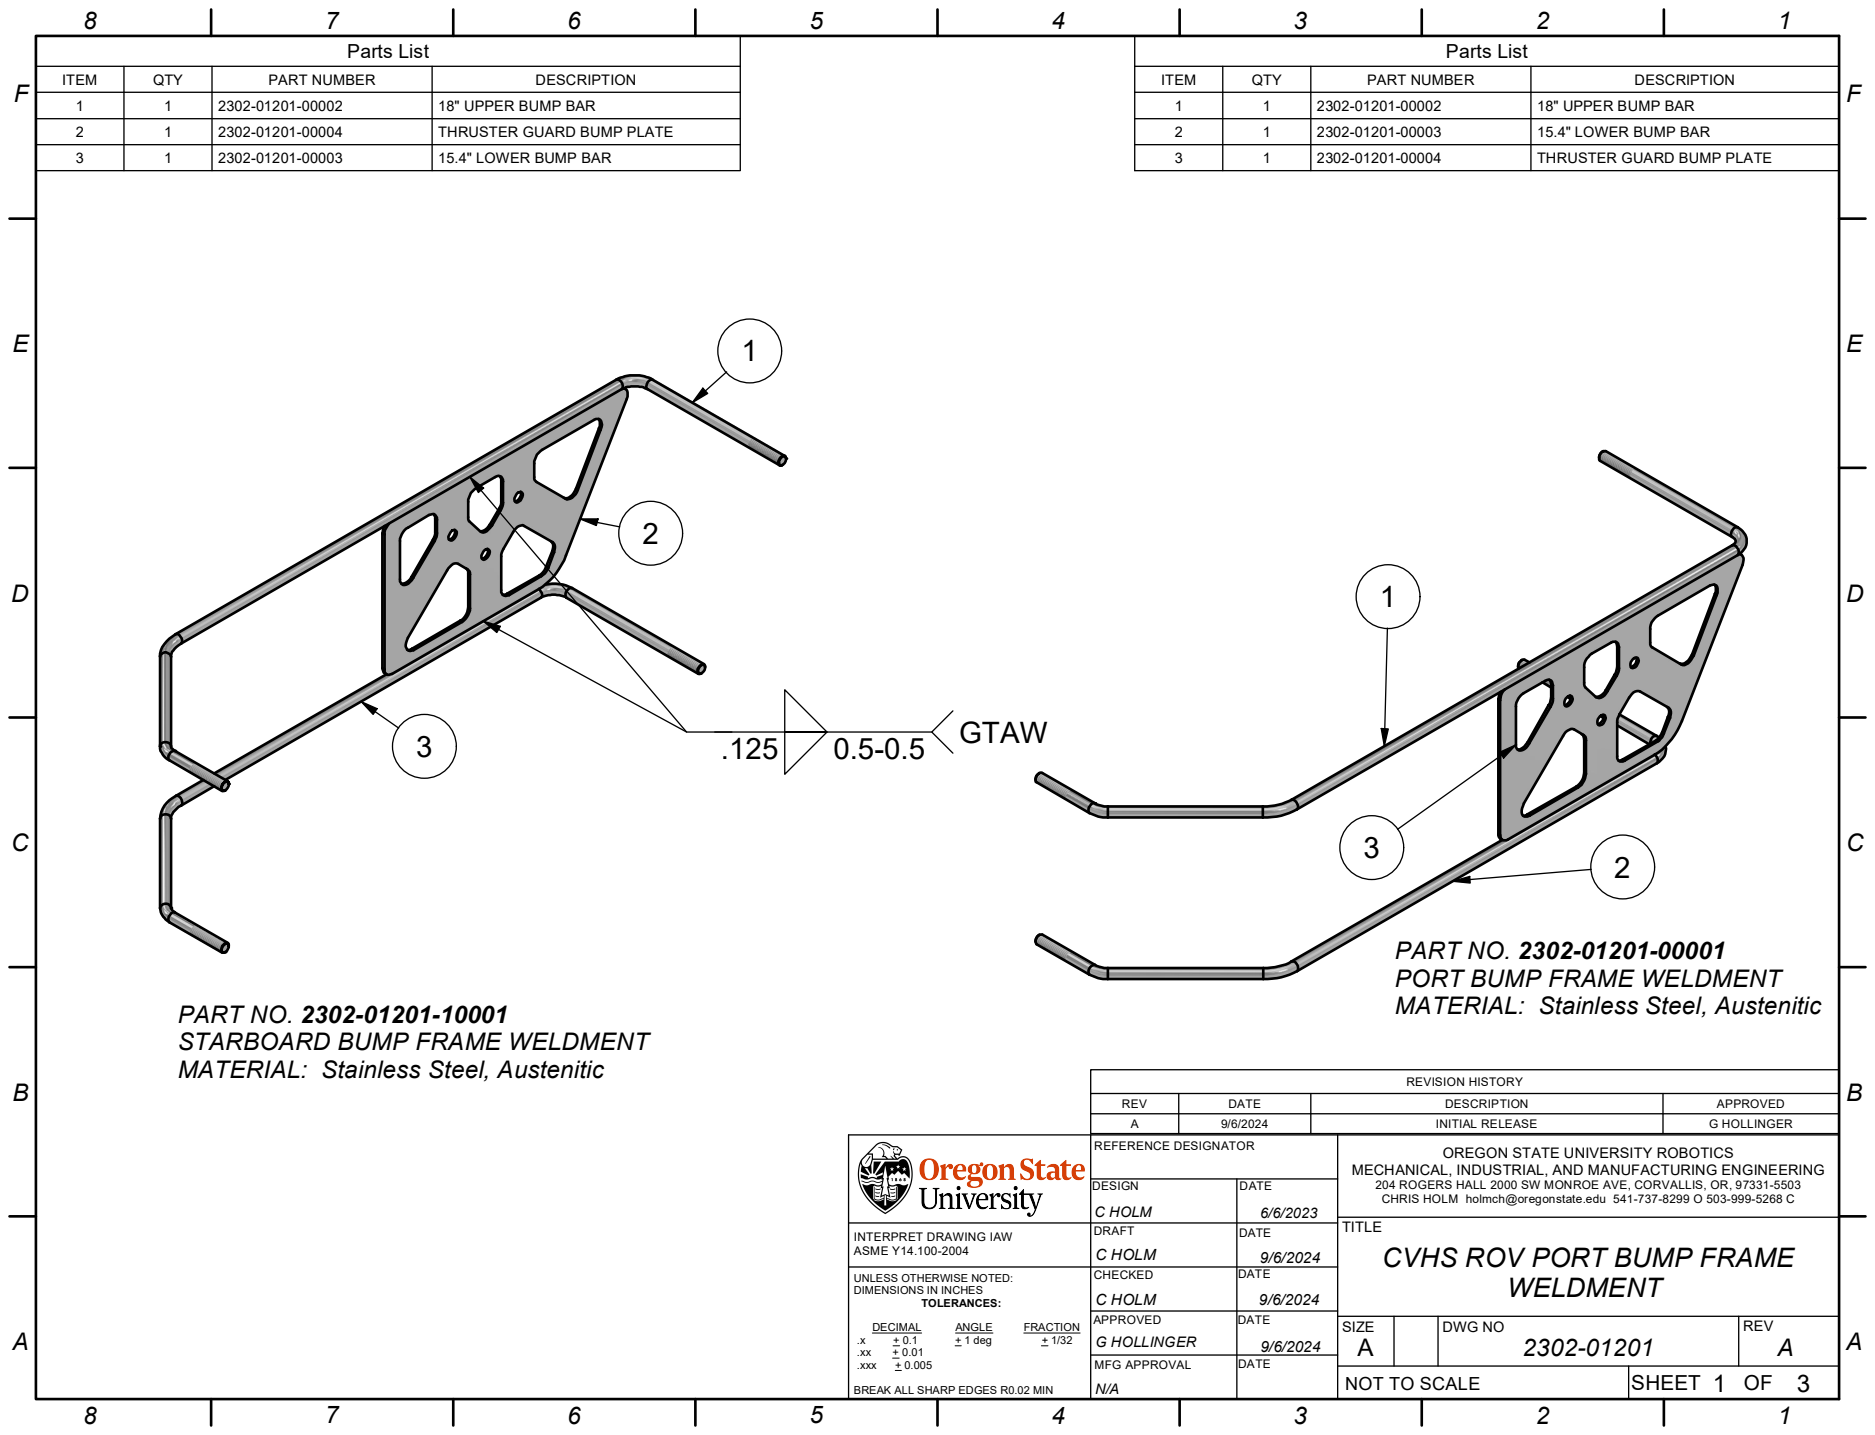
[picture p36: page 1]
Parts List; ITEM; QTY; PART NUMBER; DESCRIPTION; 18" UPPER BUMP BAR; THRUSTER GUARD BUMP PLATE; 15.4" LOWER BUMP BAR; REVISION HISTORY

PART NO. 2302-01201-00001
PORT BUMP FRAME WELDMENT

MATERIAL: Stainless Steel, Austenitic PART NO. 2302-01201-10001
STARBOARD BUMP FRAME WELDMENT
MATERIAL: Stainless Steel, Austenitic

REV | DATE | DESCRIPTION | APPROVED
A | 9/6/2024 | INITIAL RELEASE | G HOLLINGER
REFERENCE DESIGNATOR | OREGON STATE UNIVERSITY ROBOTICS MECHANICAL, INDUSTRIAL, AND MANUFACTURING ENGINEERING 204 ROGERS HALL 2000 SW MONROE AVE, CORVALLIS, OR, 97331-5503 CHRIS HOLM holmch@oregonstate.edu 541-737-8299 O 503-999-5268 C TITLE CVHS ROV PORT BUMP FRAME WELDMENT

DESIGN C HOLM | DATE 6/6/2023

INTERPRET DRAWING IAW ASME Y14.100-2004 | DRAFT C HOLM | DATE 9/6/2024

UNLESS OTHERWISE NOTED: DIMENSIONS IN INCHES TOLERANCES: DECIMAL ANGLE FRACTION .x + 0.1 + 1 deg + 1/32 .xx + 0.01 .xxx + 0.005 BREAK ALL SHARP EDGES R0.02 MIN | CHECKED C HOLM | DATE 9/6/2024

APPROVED G HOLLINGER | DATE 9/6/2024 | SIZE A | | DWG NO | REV A

MFG APPROVAL N/A | DATE

NOT TO SCALE | SHEET 1 3 OF

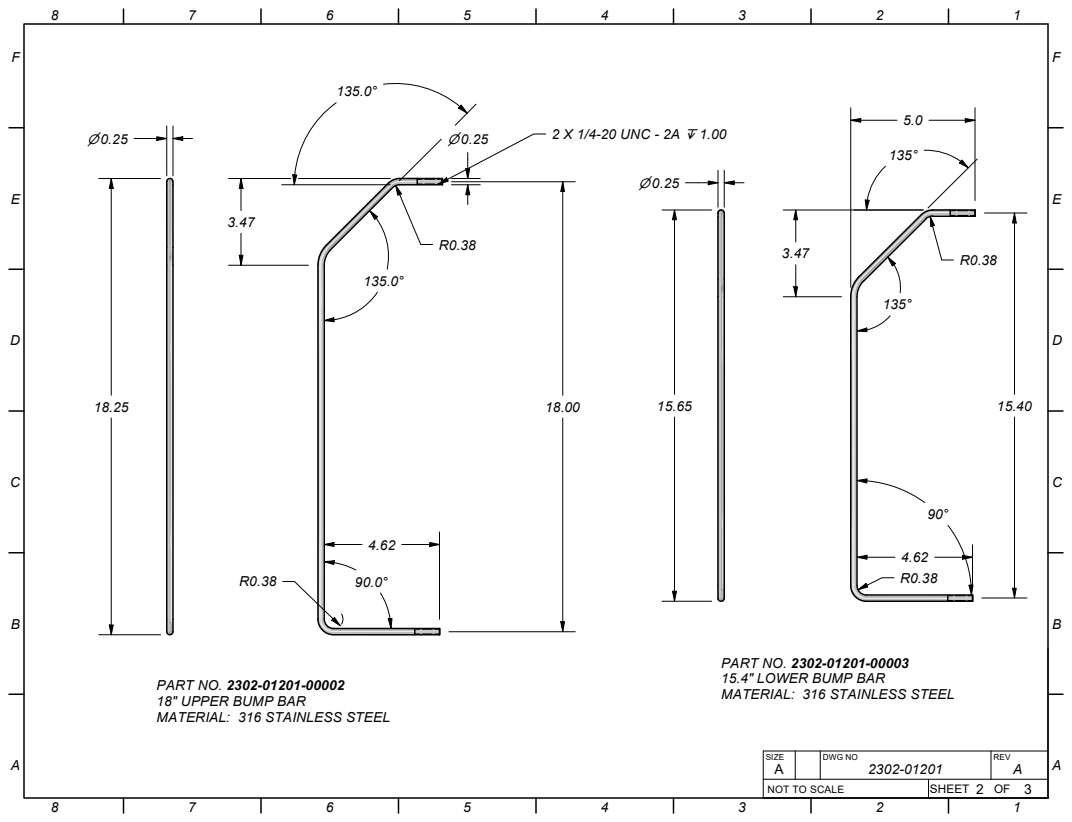
[picture p37: page 2]
2 X 1/4-20 UNC - 2A ↧ 1.00

PART NO. 2302-01201-00003
15.4" LOWER BUMP BAR
MATERIAL: 316 STAINLESS STEEL

PART NO. 2302-01201-00002
18" UPPER BUMP BAR

SIZE | | DWG NO | REV

NOT TO SCALE | 2 3 SHEET OF

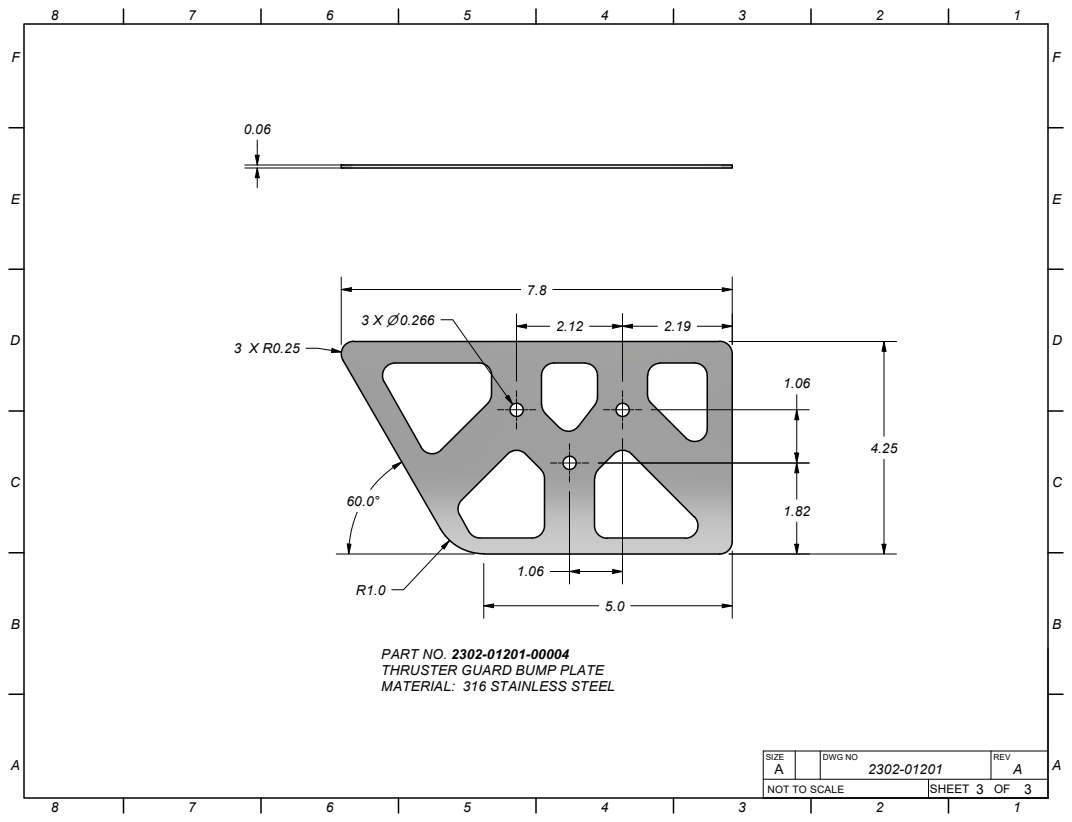
[picture p38: page 3]

PART NO. 2302-01201-00004
THRUSTER GUARD BUMP PLATE
MATERIAL: 316 STAINLESS STEEL

SIZE | | DWG NO | REV

NOT TO SCALE | 3 3 SHEET OF
