holmch11/CVHS_ROV/PDFs/2302-30202_CVHS_PI_INTERFACE_BOARD_REV-B-2024-08-16.pdf

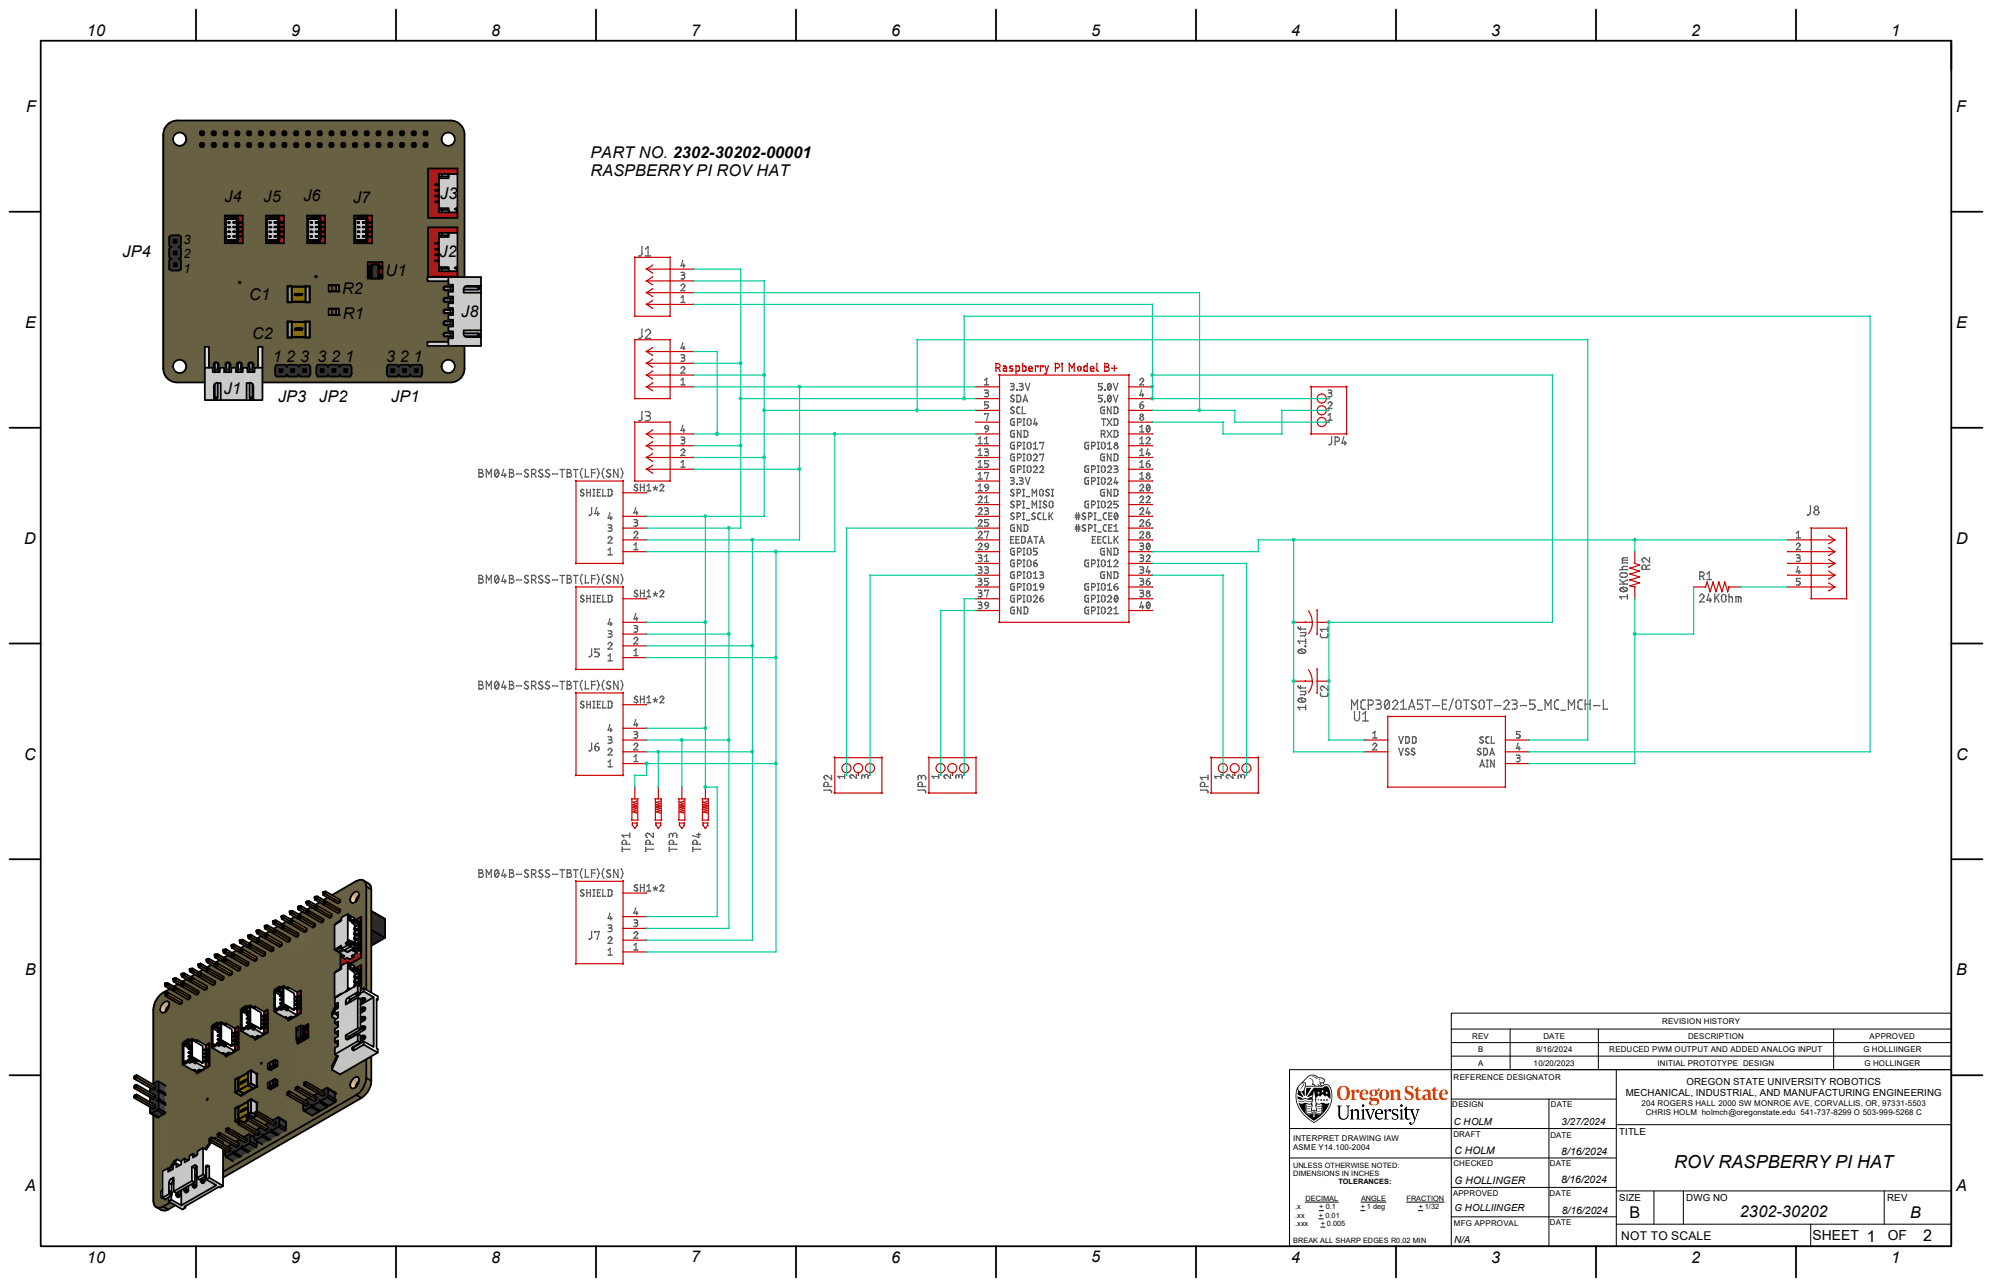
[picture p39: page 1]

PART NO. 2302-30202-00001
RASPBERRY PI ROV HAT

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

DESIGN C HOLM | DATE 3/27/2024

INTERPRET DRAWING IAW ASME Y14.100-2004 | DRAFT C HOLM | DATE 8/16/2024

APPROVED G HOLLIINGER | DATE 8/16/2024 | SIZE B | DWG NO 2302-30202 | REV B

MFG APPROVAL N/A | DATE

NOT TO SCALE | SHEET 1 2 OF

BREAK ALL SHARP EDGES R0.02 MIN

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
A | A
B | B
C | C
D | D
E | E
F | F
SIZE B | | DWG NO 2302-30202 | REV B
NOT TO SCALE | 2 2 SHEET OF

Table
Ref | Function Description | Part Description | Manufacturer | Manufacturer PN | DigiKey PN | Source
PCB1 | | Raspberry Pi 4 B 2GB | Rasberrry Pi 4 B 2GB | Raspberry Pi | SC0193(9) | 2648-SC-193(9)-ND | Digikey
A1 | | Raspberry Pi 4 B 2GB | 2 x 20 Stacking Header | Adafruit Industries LLC | 2223 | 1528-1385-ND | Digikey
J1 | | IMU Connection | JST XH Conn Header Male RA 4 pos 2.5mm | JST Sales America inc | S4B-XH-A-1 | 455-S4B-XH-A-1-ND | Digikey
J2 | | Bar30 Sensor | JST GH Conn Header Male RA 4 pos 1.25mm | JST Sales America inc | SM04B-GHS-TB | 455-1566-1-ND | Digikey
J3 | | Temp Sensor (reserved) | JST GH Conn Header Male RA 4 pos 1.25mm | JST Sales America inc | SM04B-GHS-TB | 455-1566-1-ND | Digikey
J4 | | BME680 Sensor | Stemma QT JST 1mm 4 POS Conn Header male | JST Sales America inc | BM04B-SRSS-TBT | 455-BM04B-SRSS-TBTCT-ND | Digikey
J5 | | Stemma QT 3.3 Sensor | Stemma QT JST 1mm 4 POS Conn Header male | JST Sales America inc | BM04B-SRSS-TBT | 455-BM04B-SRSS-TBTCT-ND | Digikey
J6 | | Stemma QT 3.3 Sensor | Stemma QT JST 1mm 4 POS Conn Header male | JST Sales America inc | BM04B-SRSS-TBT | 455-BM04B-SRSS-TBTCT-ND | Digikey
J7 | | Stemma QT 3.3 | Stemma QT JST 1mm 4 POS Conn Header male | JST Sales America inc | BM04B-SRSS-TBT | 455-BM04B-SRSS-TBTCT-ND | Digikey
J8 | | Battery Balance Plug | JST XH Conn Header Male RA 5 pos 2.5mm | JST Sales America inc | S5B-XH-A-A | 455-4228-ND | Digikey
JP1 | | HW-PWM0 Lights (GPIO12) | Three pin 2.54mm 0.1" Header | Wurth Electronics | 61300311121 | 732-5316-ND | Digikey
JP2 | | HW-PWM1 (GPIO13) | Three pin 2.54mm 0.1" Header | Wurth Electronics | 61300311121 | 732-5316-ND | Digikey
JP3 | | Light Alternate (GPIO26) | Three pin 2.54mm 0.1" Header | Wurth Electronics | 61300311121 | 732-5316-ND | Digikey
JP4 | | Cooling Fan | Three pin 2.54mm 0.1" Header | Wurth Electronics | 61300311121 | 732-5316-ND | Digikey
U1 | | Analog to Digital Converter | 10Bit Analog to Digital Converter 1 input | Microchip Technology | MCP3021A5T-E/OT | MCP3021A5T-E/OTCT-ND | Digikey
C1 | | Noise Capacitor | 0.1 uf Capacitor Surface Mount 1812 | KEMET | C1812X104KDRAC7800 | 399-C1812X104KDRAC7800CT-ND | Digikey
C2 | | Noise Capacitor | 10 uf Capacitor Surface Mount 1812 | KEMET | C1812C106K3RAC7800 | 399-C1812C106K3RAC7800CT-ND | Digikey
R1 | | R1 Voltage Divider | 24KOhm 0.05% 1/8W 0805 | Panasonic Electronic Components | ERA-6VRW243V | P24KBSCT-ND | Digikey
R2 | | R2 Voltage Divider | 10KOhm 0.05% 1/4W 0805 | Panasonic Electronic Components | ERA-6VRW1002V | 10-ERA-6VRW1002VCT-ND | Digikey

Offboard Connnections

J100 | IMU | IMU Board Connection | JST XH Conn Header Male vert 4 pos 2.5mm | JST Sales America inc | B4B-XH-A | 455-B4B-XH-A-ND | Digikey
HS1 | FAN | Cooling Fan | Armor Lite Heat Sink with PWM Fan | Seeed Technology Co. LTd | 114992661 | 1597-114992661-ND | Digikey
