holmch11/CVHS_ROV/PDFs/2302-30302_CVHS_ARDUINO_UNO_INTERFACE_BOARD_REV-B-2024-08-16.pdf

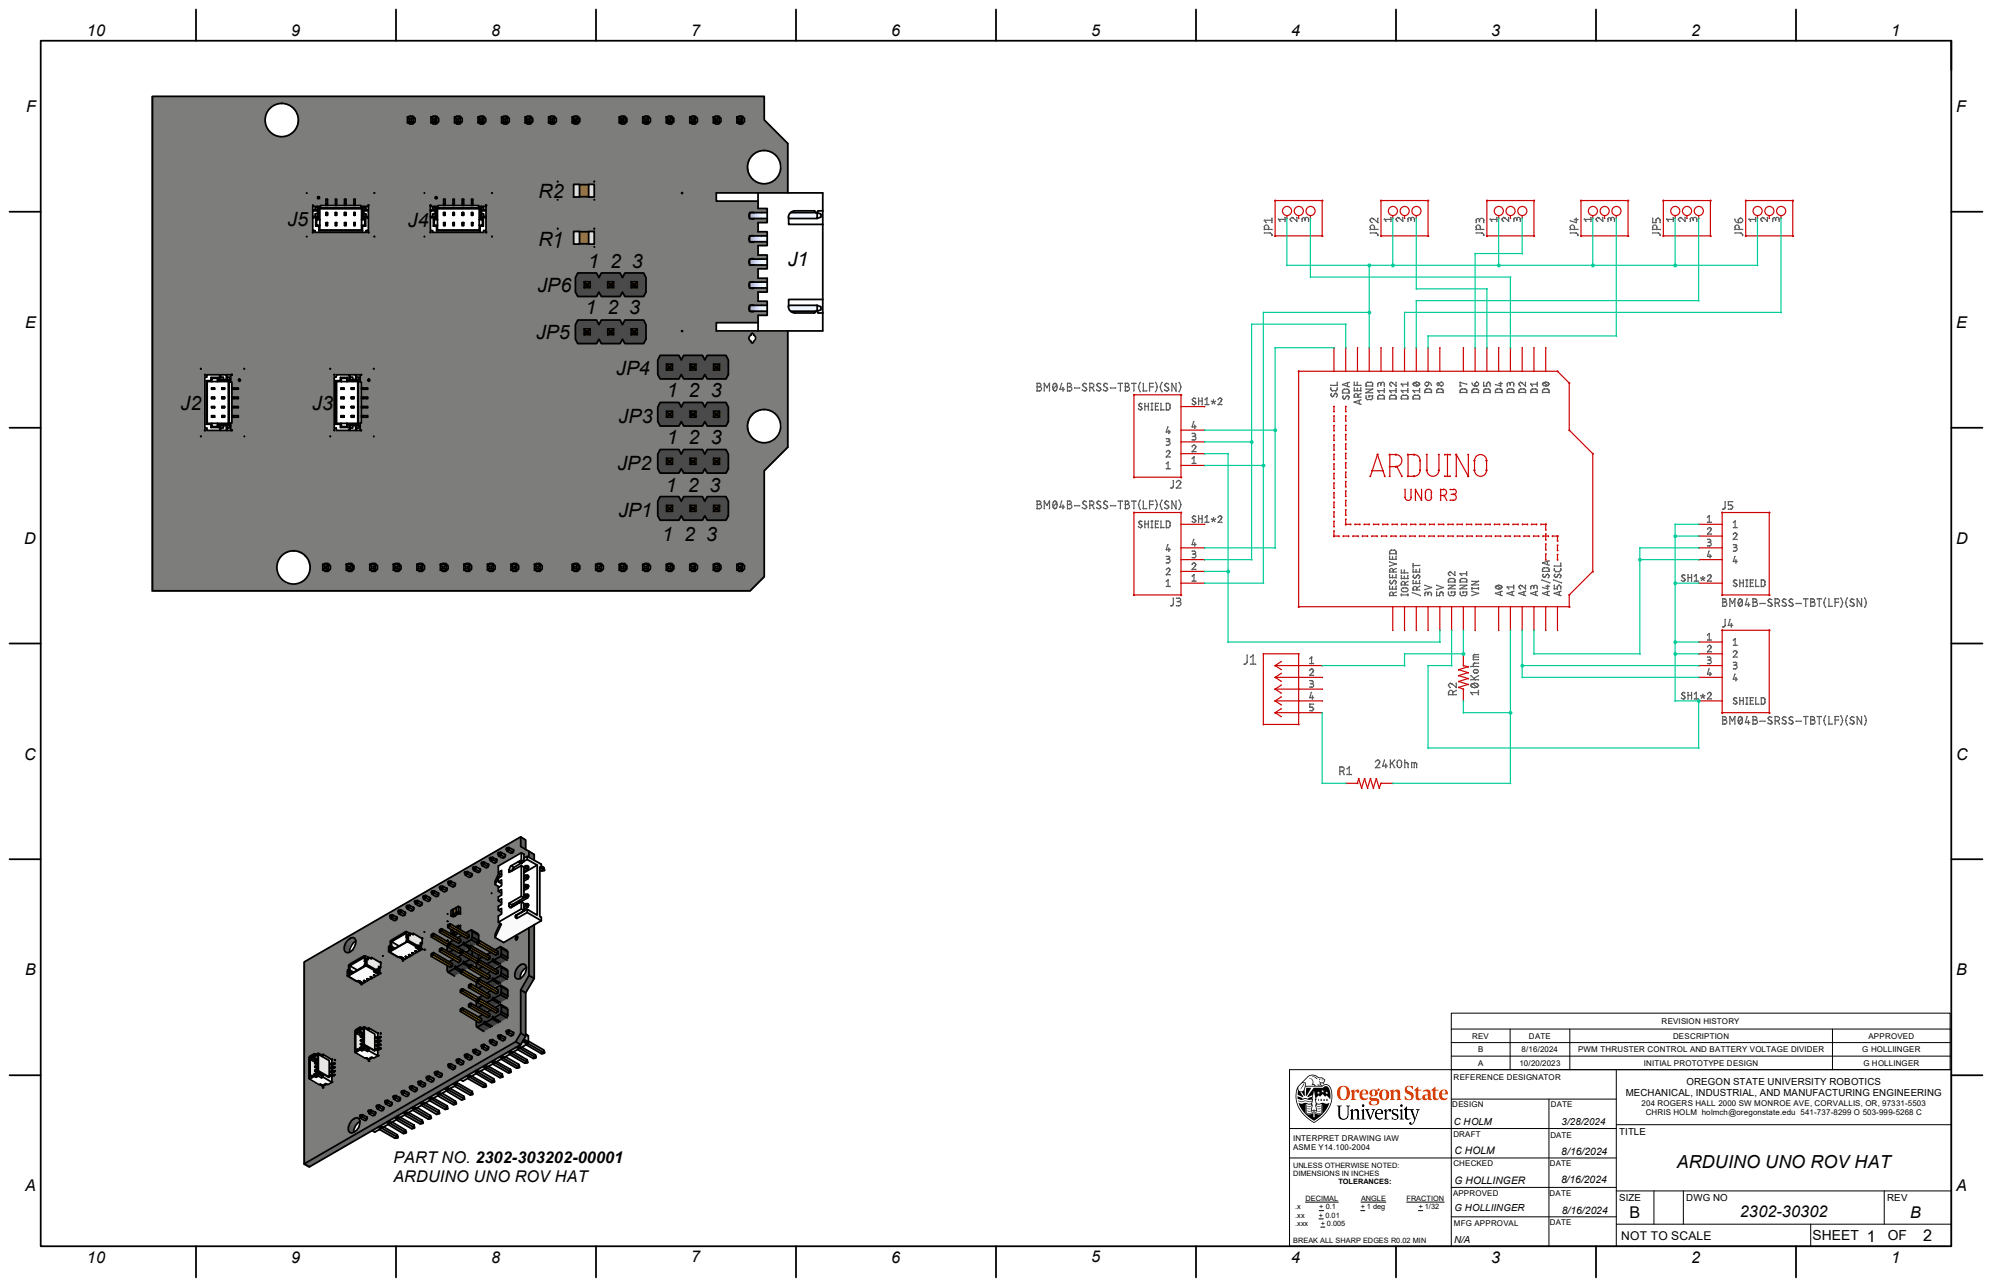
[picture p40: page 1]

REFERENCE DESIGNATOR | OREGON STATE UNIVERSITY ROBOTICS MECHANICAL, INDUSTRIAL, AND MANUFACTURING ENGINEERING 204 ROGERS HALL 2000 SW MONROE AVE, CORVALLIS, OR, 97331-5503 CHRIS HOLM holmch@oregonstate.edu 541-737-8299 O 503-999-5268 C

DESIGN C HOLM | DATE 3/28/2024

INTERPRET DRAWING IAW ASME Y14.100-2004 | DRAFT C HOLM | DATE 8/16/2024

PART NO. 2302-303202-00001
ARDUINO UNO ROV HAT

UNLESS OTHERWISE NOTED: TOLERANCES: DECIMAL ANGLE FRACTION .x + 0.1 + 1 deg + 1/32 .xx + 0.01 .xxx + 0.005 BREAK ALL SHARP EDGES R0.02 MIN | CHECKED G HOLLINGER | DATE 8/16/2024 | ARDUINO UNO ROV HAT DIMENSIONS IN INCHES

APPROVED G HOLLIINGER | DATE 8/16/2024 | SIZE B | | DWG NO 2302-30302 | REV B

MFG APPROVAL N/A | DATE

NOT TO SCALE | SHEET 1 2 OF

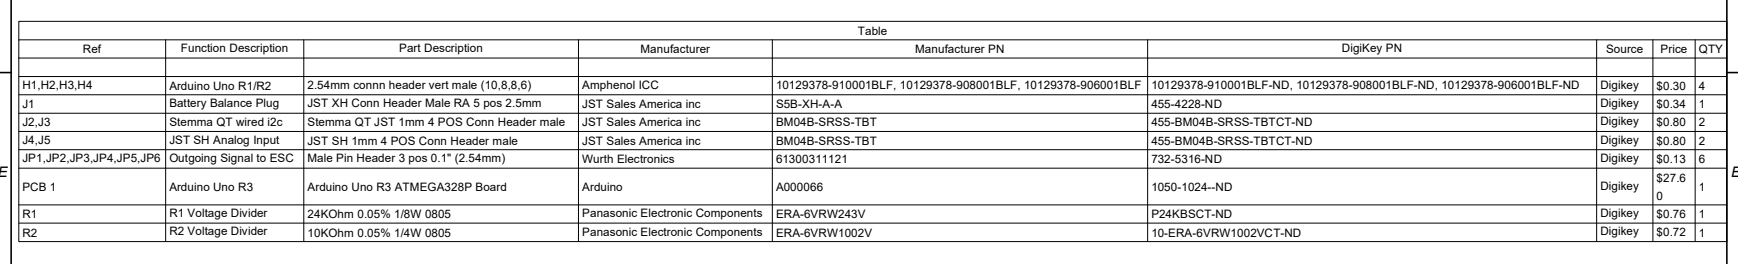
[picture p41: page 2]
Ref; Function Description; Part Description; Manufacturer; Manufacturer PN; DigiKey PN; Source; Price; QTY

H1,H2,H3,H4 | Arduino Uno R1/R2 | 2.54mm connn header vert male (10,8,8,6) | Amphenol ICC | 10129378-910001BLF, 10129378-908001BLF, 10129378-906001BLF | 10129378-910001BLF-ND, 10129378-908001BLF-ND, 10129378-906001BLF-ND | Digikey | $0.30 | 4
J1 | Battery Balance Plug | JST XH Conn Header Male RA 5 pos 2.5mm | JST Sales America inc | S5B-XH-A-A | 455-4228-ND | Digikey | $0.34 | 1
J2,J3 | Stemma QT wired i2c | Stemma QT JST 1mm 4 POS Conn Header male | JST Sales America inc | BM04B-SRSS-TBT | 455-BM04B-SRSS-TBTCT-ND | Digikey | $0.80 | 2
J4,J5 | JST SH Analog Input | JST SH 1mm 4 POS Conn Header male | JST Sales America inc | BM04B-SRSS-TBT | 455-BM04B-SRSS-TBTCT-ND | Digikey | $0.80 | 2
JP1,JP2,JP3,JP4,JP5,JP6 | Outgoing Signal to ESC | Male Pin Header 3 pos 0.1" (2.54mm) | Wurth Electronics | 61300311121 | 732-5316-ND | Digikey | $0.13 | 6
PCB 1 | Arduino Uno R3 | Arduino Uno R3 ATMEGA328P Board | Arduino | A000066 | 1050-1024--ND | Digikey | $27.6 0 | 1

R1 | R1 Voltage Divider | 24KOhm 0.05% 1/8W 0805 | Panasonic Electronic Components | ERA-6VRW243V | P24KBSCT-ND | Digikey | $0.76 | 1
R2 | R2 Voltage Divider | 10KOhm 0.05% 1/4W 0805 | Panasonic Electronic Components | ERA-6VRW1002V | 10-ERA-6VRW1002VCT-ND | Digikey | $0.72 | 1

SIZE B | | DWG NO 2302-30302 | REV B

NOT TO SCALE | 2 2 SHEET OF
