holmch11/CVHS_ROV/(notices)

Notices in the files:
SUB/Comms/Controller.py:
it under the terms of the GNU General Public License as published by
